giacomofratus/Stretcher_Stabilization/README.md

# Stretcher_Stabilization
Capstone project for UCLA EE183
