giacomofratus/Stretcher_Stabilization/Webot_Simulation/README.md

Files with "Uncompensated" in name have results for uncompensated system. Other files have results for compensated system

150kg.doc: Results for {misc,gust,step,sin} disturbance on 150kg body

1Off.doc:  Results for {misc} disturbance with 1 Device Off Center on Average body

2OffDiff.doc: Results for {misc} disturbance with 2 Device Off Center in Different Direction on Average body

2OffSame.doc: Results for {misc} disturbance with 2 Device Off Center in Same Direction on Average body

3SDAbove.doc: Results for {misc,gust,step,sin} disturbance on 3SD Above Average body

3SDBelow.doc: Results for {misc,gust,step,sin} disturbance on 3SD Below Average body

Empty Stretcher Max Gust.doc: Results for {maxgust} disturbance on Empty Stretcher

Empty Stretcher Max Step.doc: Results for {maxstep} disturbance on Empty Stretcher

Empty Stretcher.doc: Results for {misc,gust,step,sin} disturbance on Empty Stretcher

Head AvgBody Misc.doc:  Results for {misc} disturbance with Head Position on Average body

Statistical_Analysis.doc: Results Statistical Analysis for {misc,gust,step,sin} disturbance on Average body

Tail AvgBody Misc.doc: Results for {misc} disturbance with Tail Position on Average body

Uncompensated 150kg.doc: Results for {misc,gust,step,sin} disturbance on 150kg body

Uncompensated 1Off.doc: Results for {misc} disturbance with 1 Device Off Center on Average body

Uncompensated 2OffDiff.doc: Results for {misc} disturbance with 2 Device Off Center in Different Direction on Average body

Uncompensated 2OffSame.doc: Results for {misc} disturbance with 2 Device Off Center in Same Direction on Average body
 
Uncompensated 3SD Above.doc: Results for {misc,gust,step,sin} disturbance on 3SD Above Average body

Uncompensated 3SD Below.doc: Results for {misc,gust,step,sin} disturbance on 3SD Below Average body

Uncompensated 3SDAbove Head.doc: Results for {misc,gust,step,sin} disturbance with Head Position on 3SD Above Average body

Uncompensated Average Body.doc: Results for {misc,gust,step,sin} disturbance on Average body

Uncompensated Empty Stretcher.doc: Results for {misc,gust,step,sin} disturbance on Empty Stretcher

Uncompensated Head 150kg.doc: Results for {misc,gust,step,sin} disturbance with Head Position on 150kg body

Uncompensated Head 3SDBelow.doc: Results for {misc,gust,step,sin} disturbance with Head Position on 3SD Below Average body

Uncompensated Head AvgBody.doc: Results for {misc,gust,step,sin} disturbance with Head Position on Average body

Uncompensated Tail 150kg.doc: Results for {misc,gust,step,sin} disturbance with Tail Position on 150kg body

Uncompensated Tail 3SDAbove.doc: Results for {misc,gust,step,sin} disturbance with Tail Position on 3SD Above Average body

Uncompensated Tail 3SDBelow.doc: Results for {misc,gust,step,sin} disturbance with Tail Position on 3SD Below Average body

Uncompensated Tail AvgBody.doc: Results for {misc,gust,step,sin} disturbance with Tail Position on Average body

avgBody.doc: Results for {misc,gust,step,sin} disturbance on Average body
