giacomofratus/Stretcher_Stabilization/Technical_Drawings/README.txt

README

This folder contains all the drawings for the main and sub-assemblies. All drawings are for the main assembly, with a special folder for parts in the sub-assembly that excludes parts not in the main assembly.
