giacomofratus/Stretcher_Stabilization/Analytical Simulation/System Dynamics/README

Document(s) outlining the mathmatical models we use to simulate a rotating body, rotational inertia, actuator thrust, and disturbance
