giacomofratus/Stretcher_Stabilization/Technical_Drawings/chassis_part.JPG

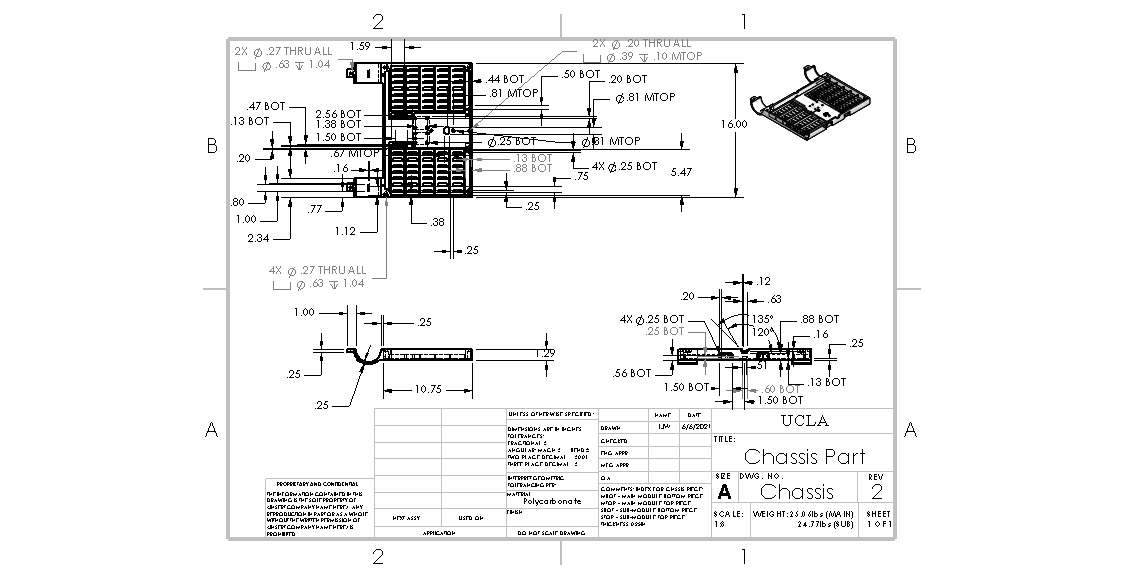
Technical_Drawings/chassis_part.JPG
