giacomofratus/Stretcher_Stabilization/Technical_Drawings/Corner Mount.JPG

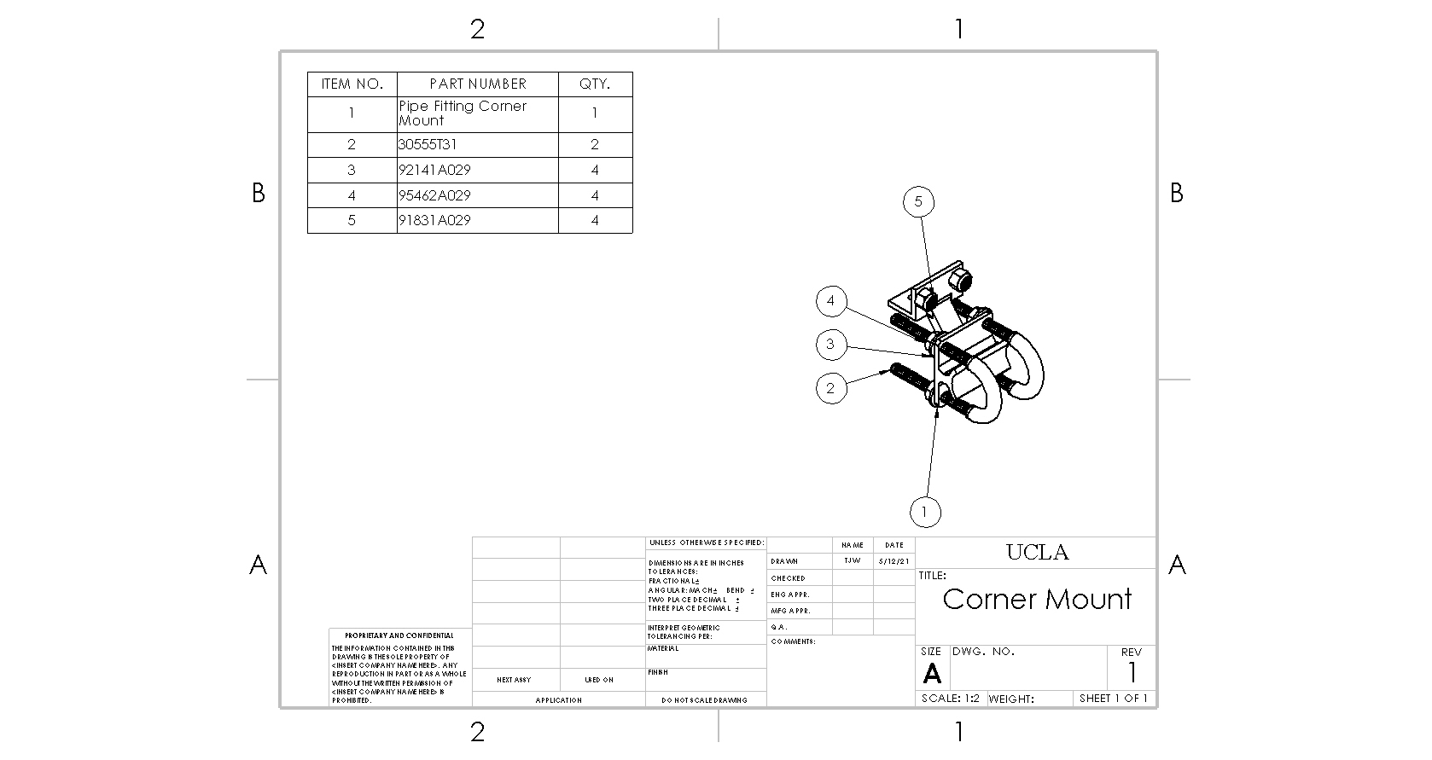
Technical_Drawings/Corner Mount.JPG
