giacomofratus/Stretcher_Stabilization/Technical_Drawings/CPU Housing-1.jpg

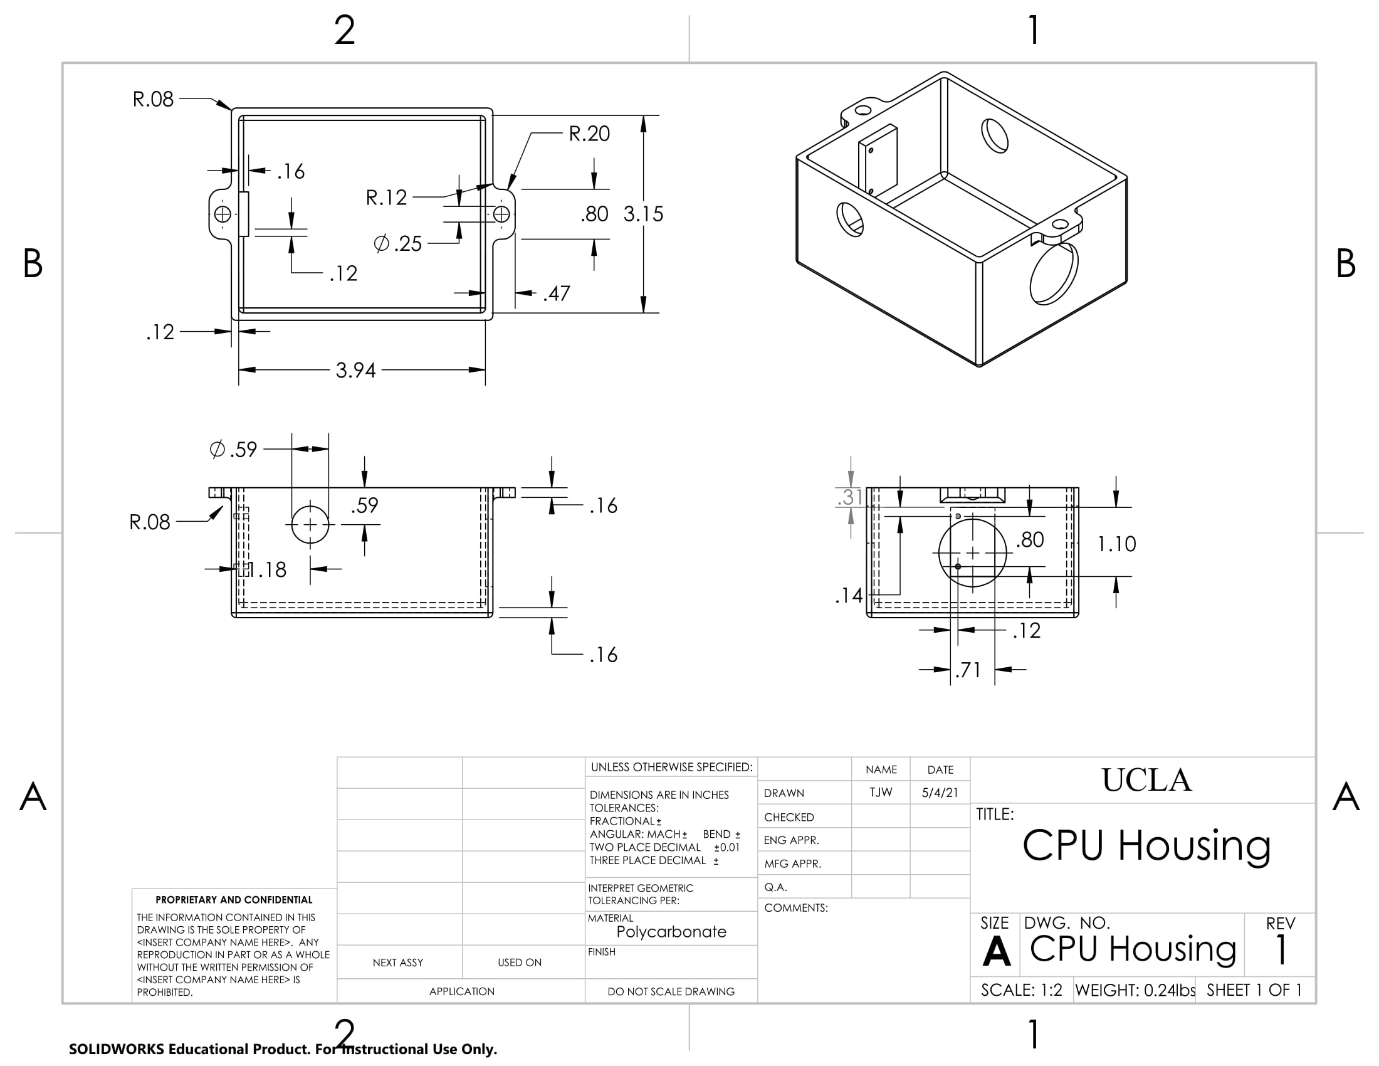
Technical_Drawings/CPU Housing-1.jpg
