giacomofratus/Stretcher_Stabilization/Technical_Drawings/ElectricHousingFULL.JPG

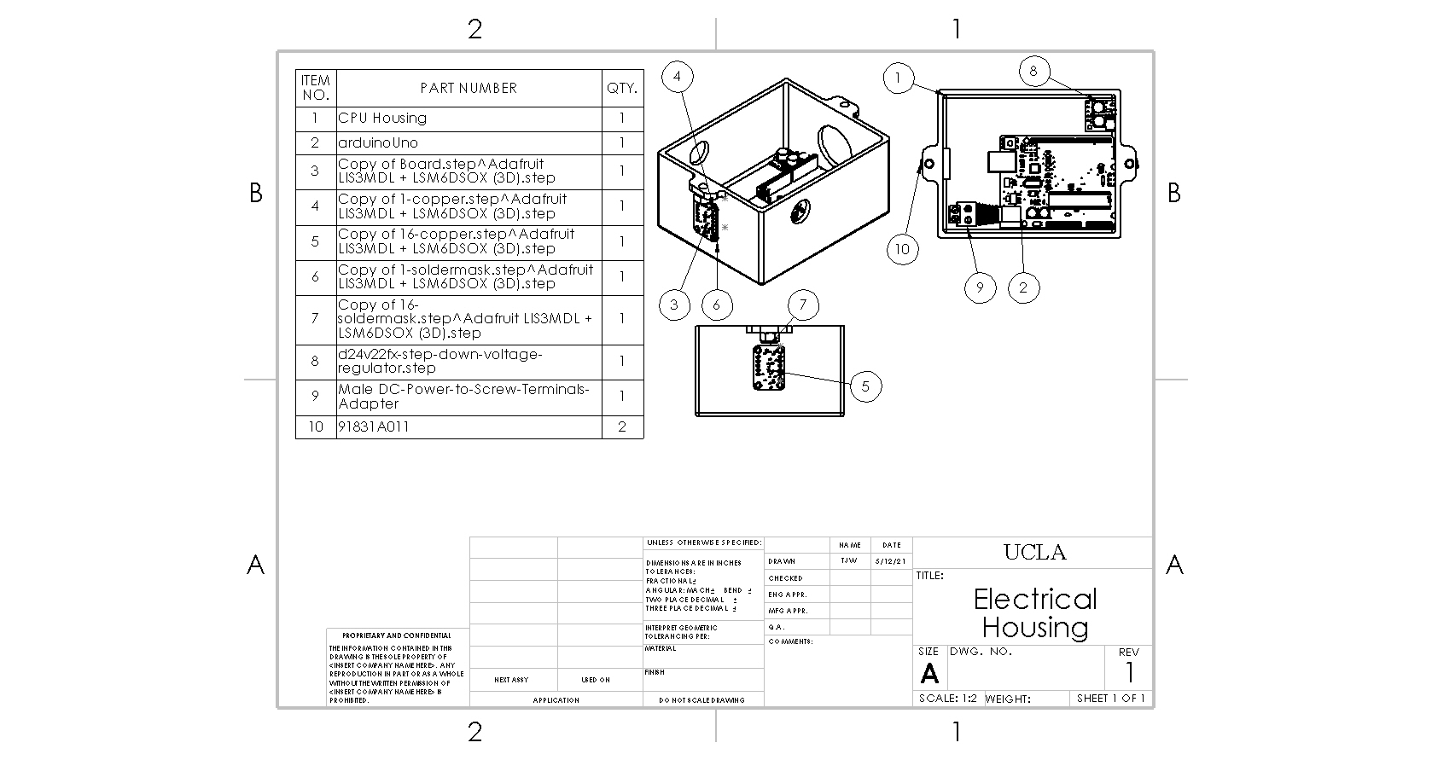
Technical_Drawings/ElectricHousingFULL.JPG
