giacomofratus/Stretcher_Stabilization/Technical_Drawings/foam_battery-1.jpg

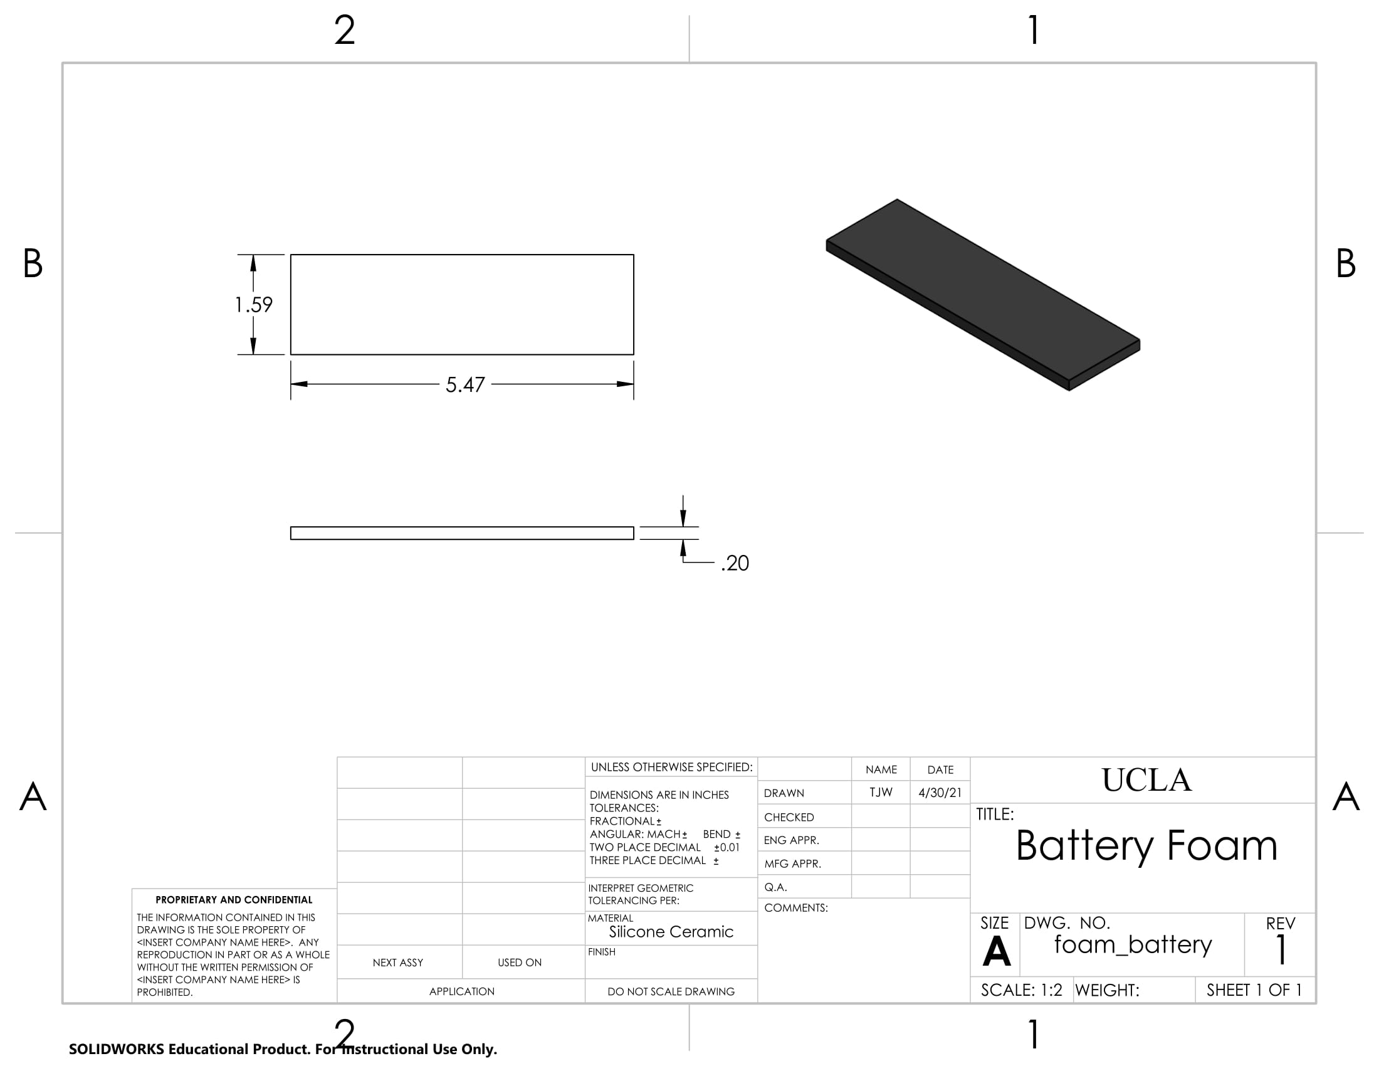
Technical_Drawings/foam_battery-1.jpg
