giacomofratus/Stretcher_Stabilization/Technical_Drawings/foam_ESC-1.jpg

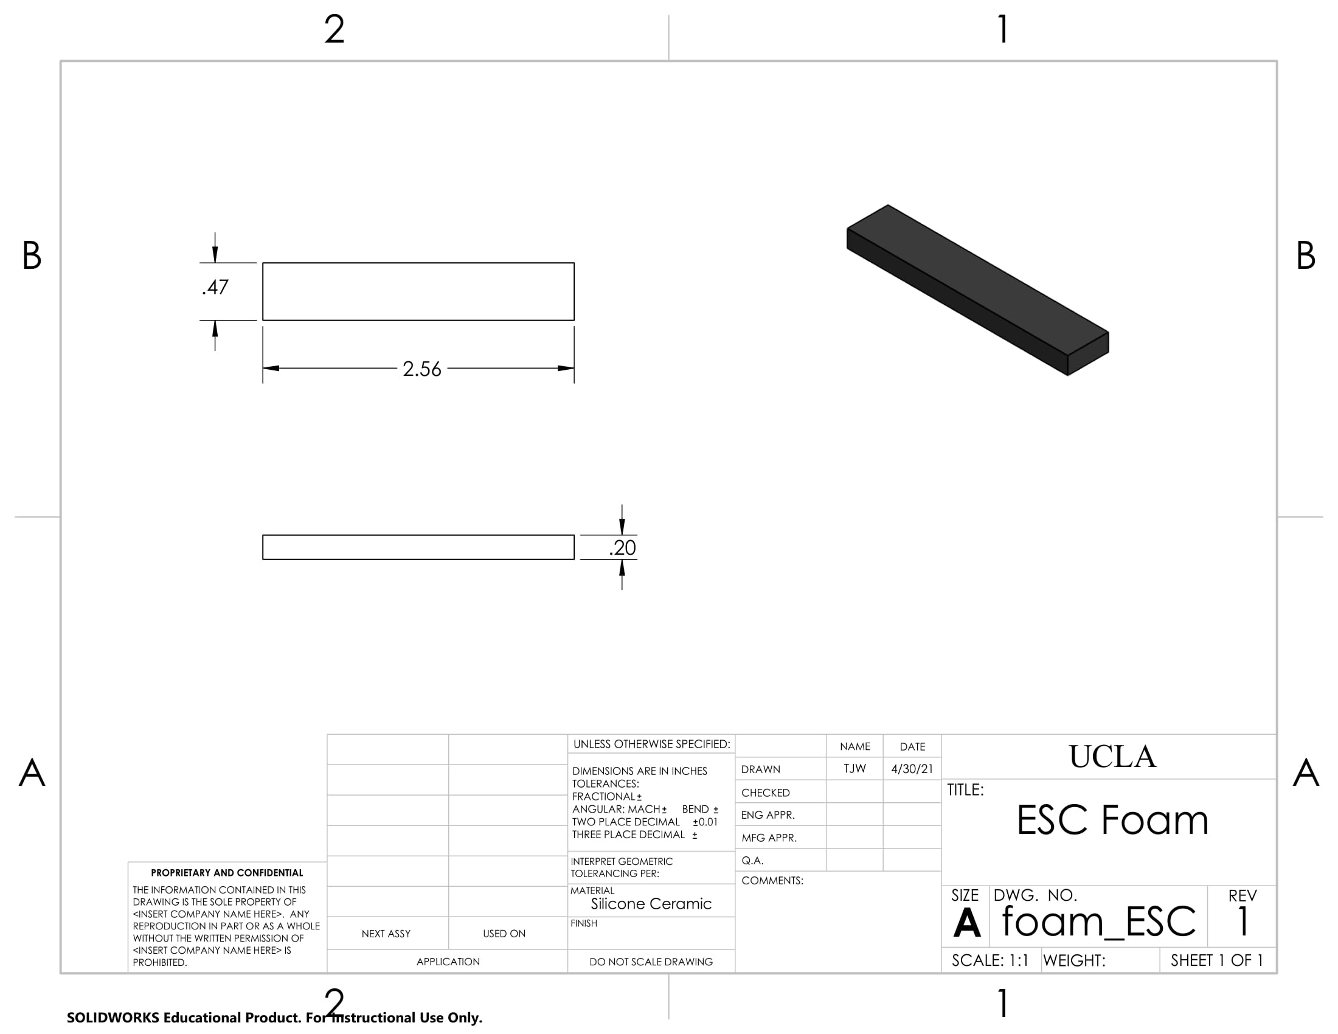
Technical_Drawings/foam_ESC-1.jpg
