giacomofratus/Stretcher_Stabilization/Technical_Drawings/LIS3MDL.png

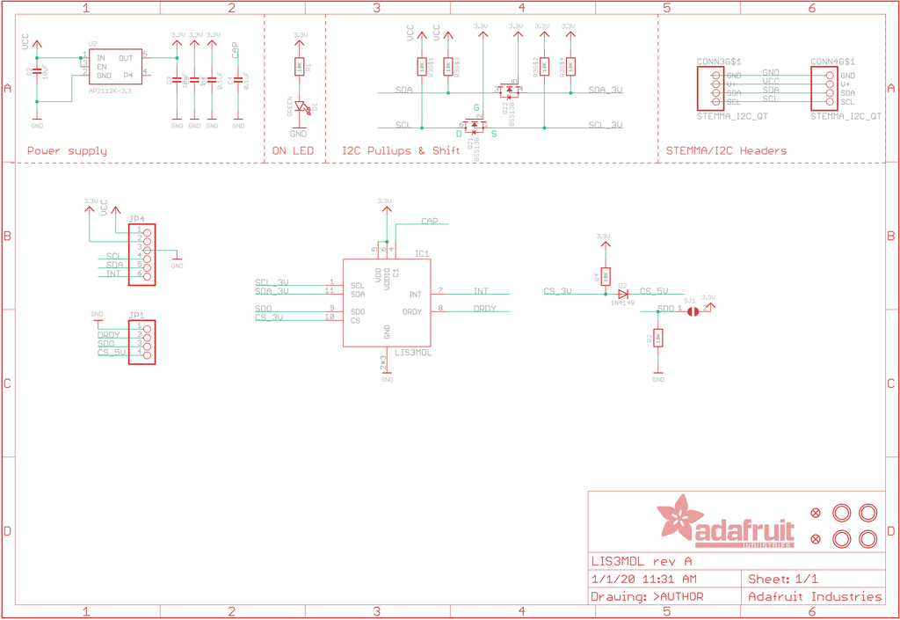
Technical_Drawings/LIS3MDL.png
