giacomofratus/Stretcher_Stabilization/Technical_Drawings/LSM6DSOX.png

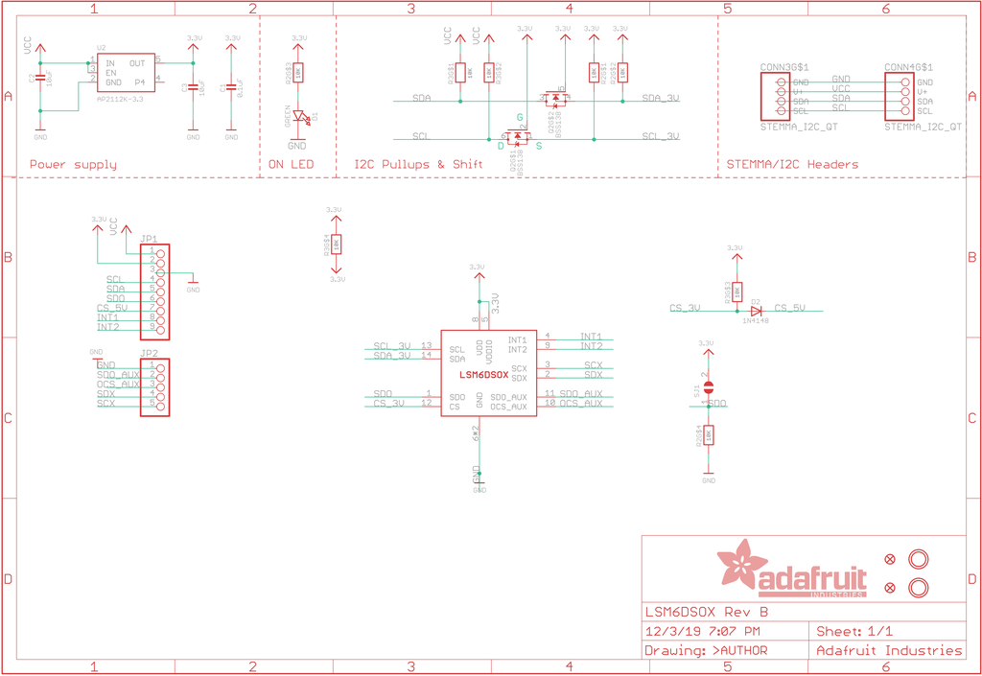
Technical_Drawings/LSM6DSOX.png
