giacomofratus/Stretcher_Stabilization/Technical_Drawings/pf-edf-70mm.png

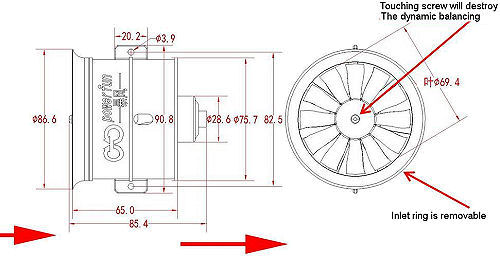
Technical_Drawings/pf-edf-70mm.png
