giacomofratus/Stretcher_Stabilization/Technical_Drawings/Pipe Fitting Corner Mount-1.jpg

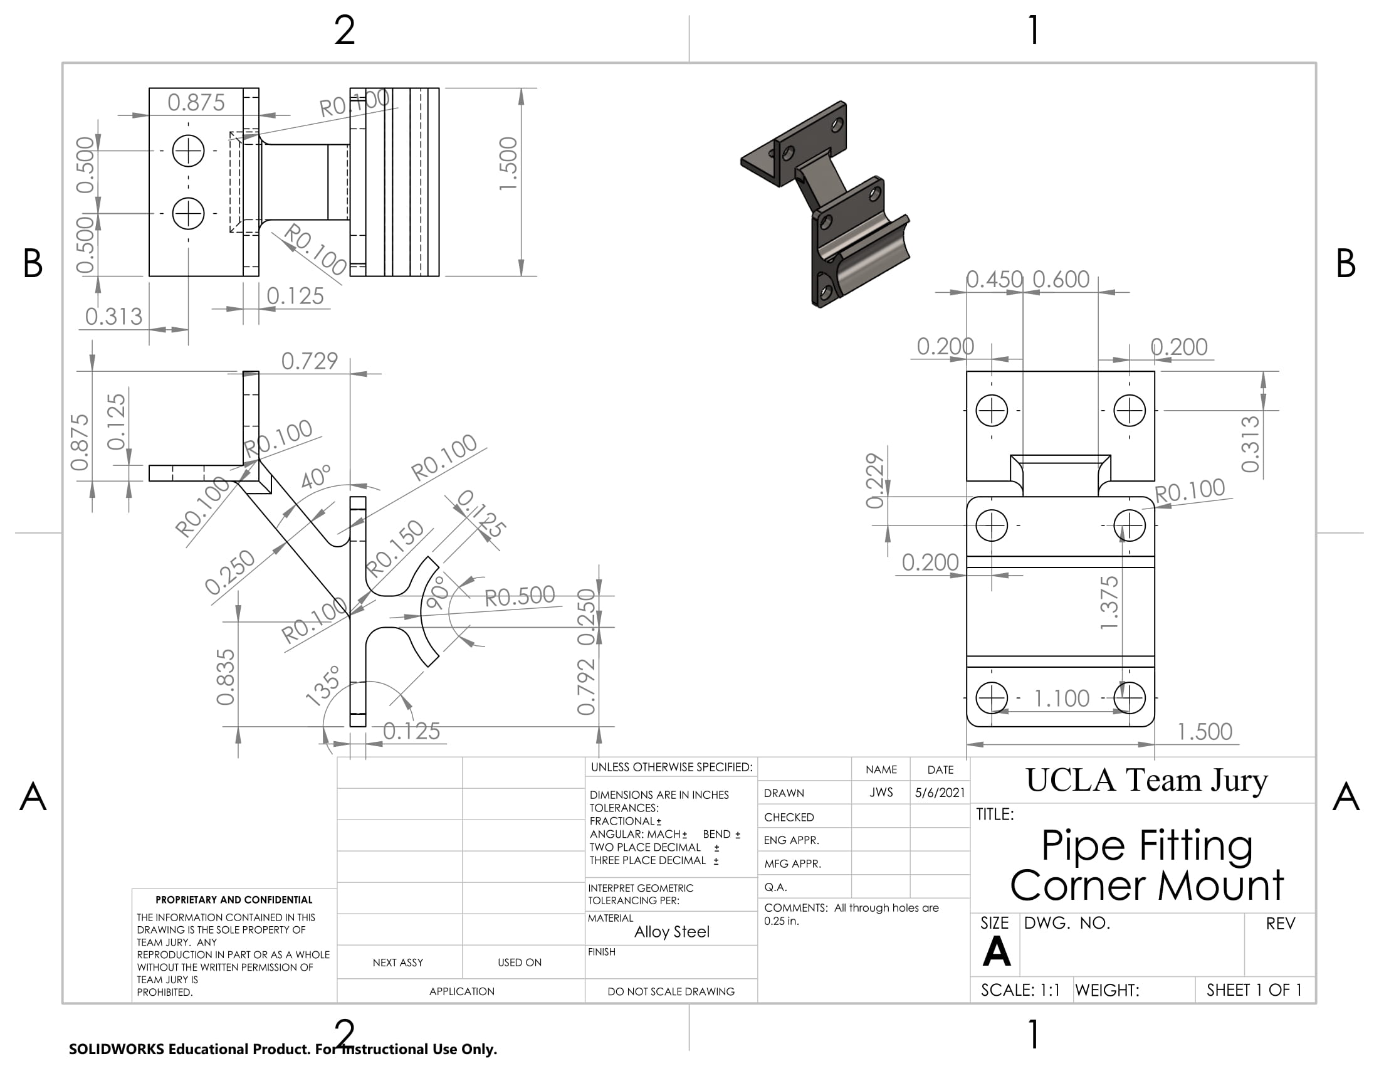
Technical_Drawings/Pipe Fitting Corner Mount-1.jpg
