giacomofratus/Stretcher_Stabilization/Technical_Drawings/Pipe Fitting Hole-1.jpg

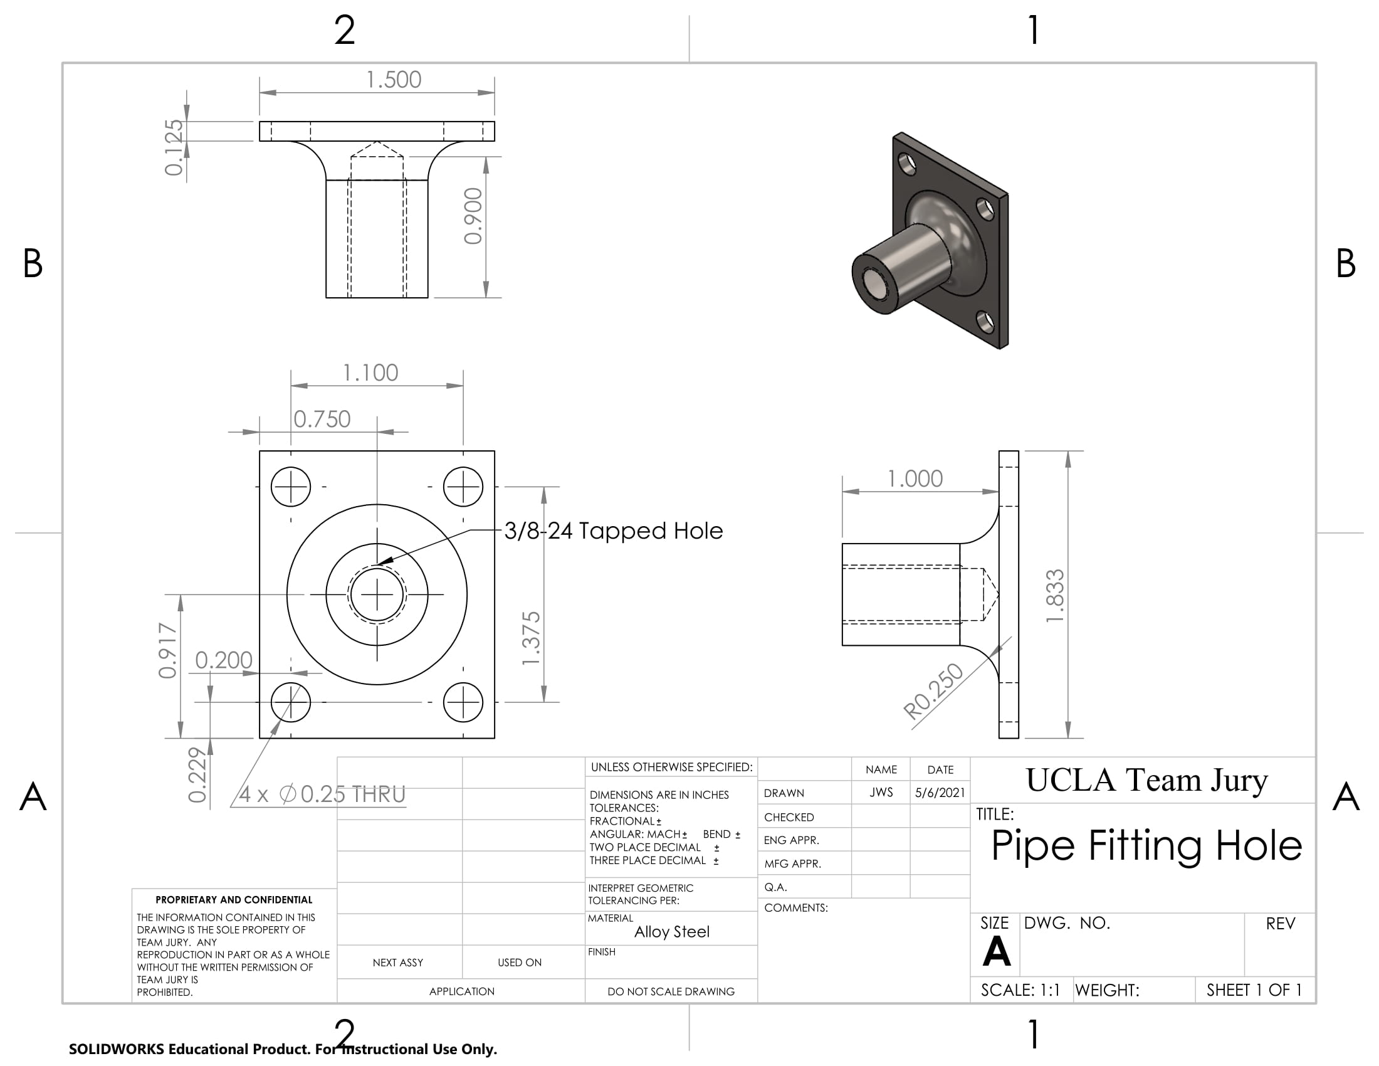
Technical_Drawings/Pipe Fitting Hole-1.jpg
