giacomofratus/Stretcher_Stabilization/Technical_Drawings/Pipe Fitting-1.jpg

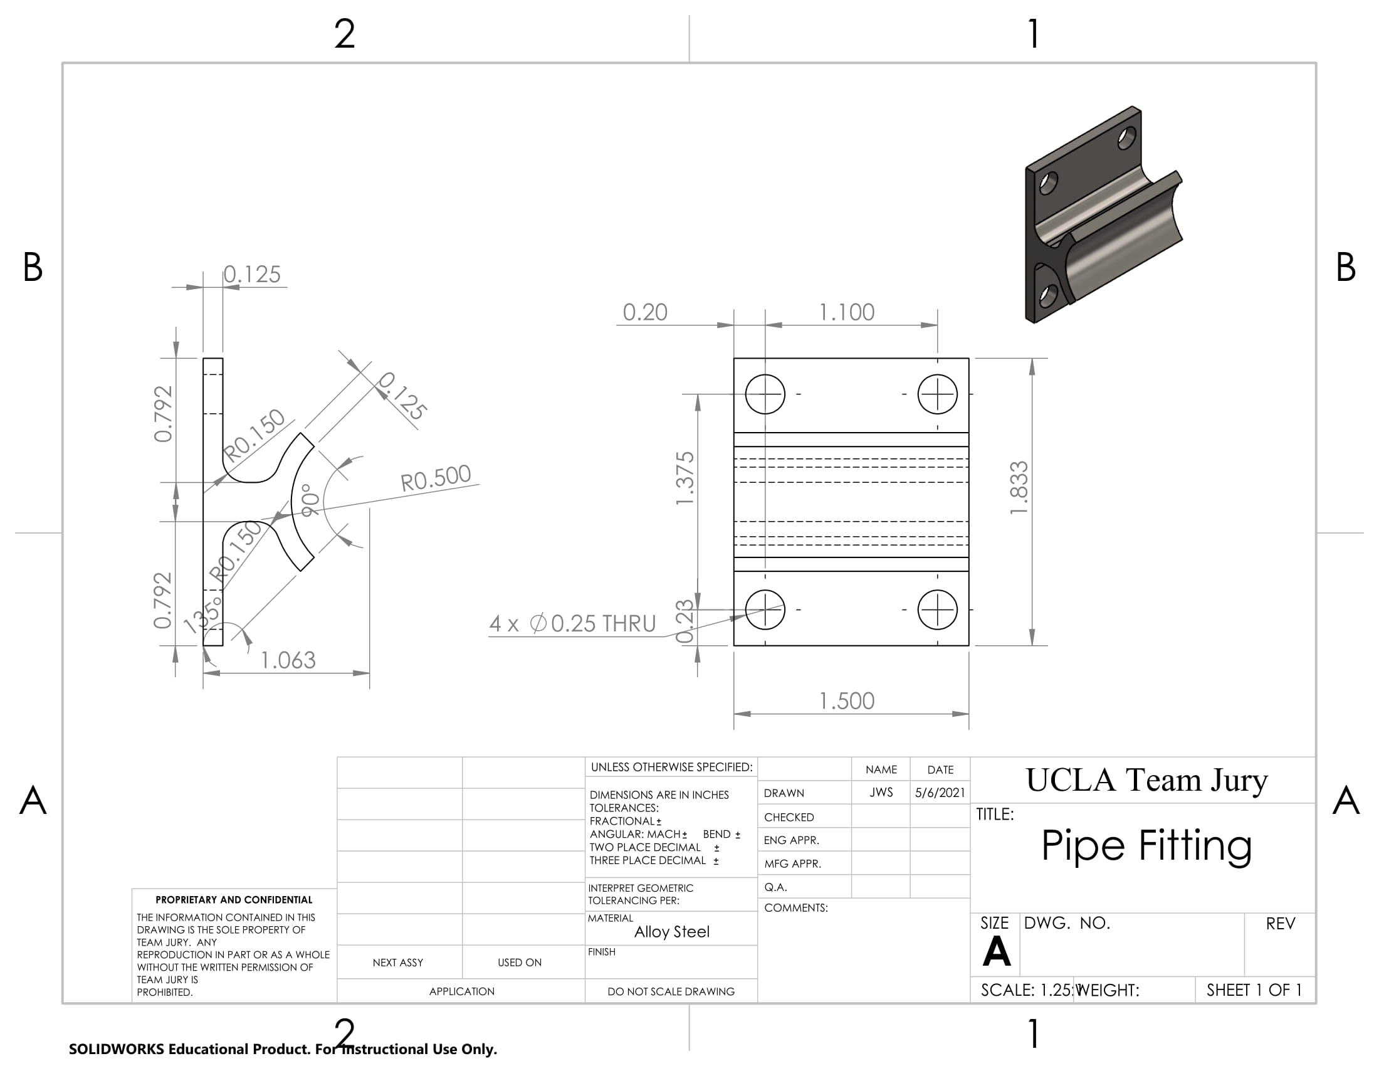
Technical_Drawings/Pipe Fitting-1.jpg
