giacomofratus/Stretcher_Stabilization/Technical_Drawings/Underside Chassis Mount Inline V2.JPG

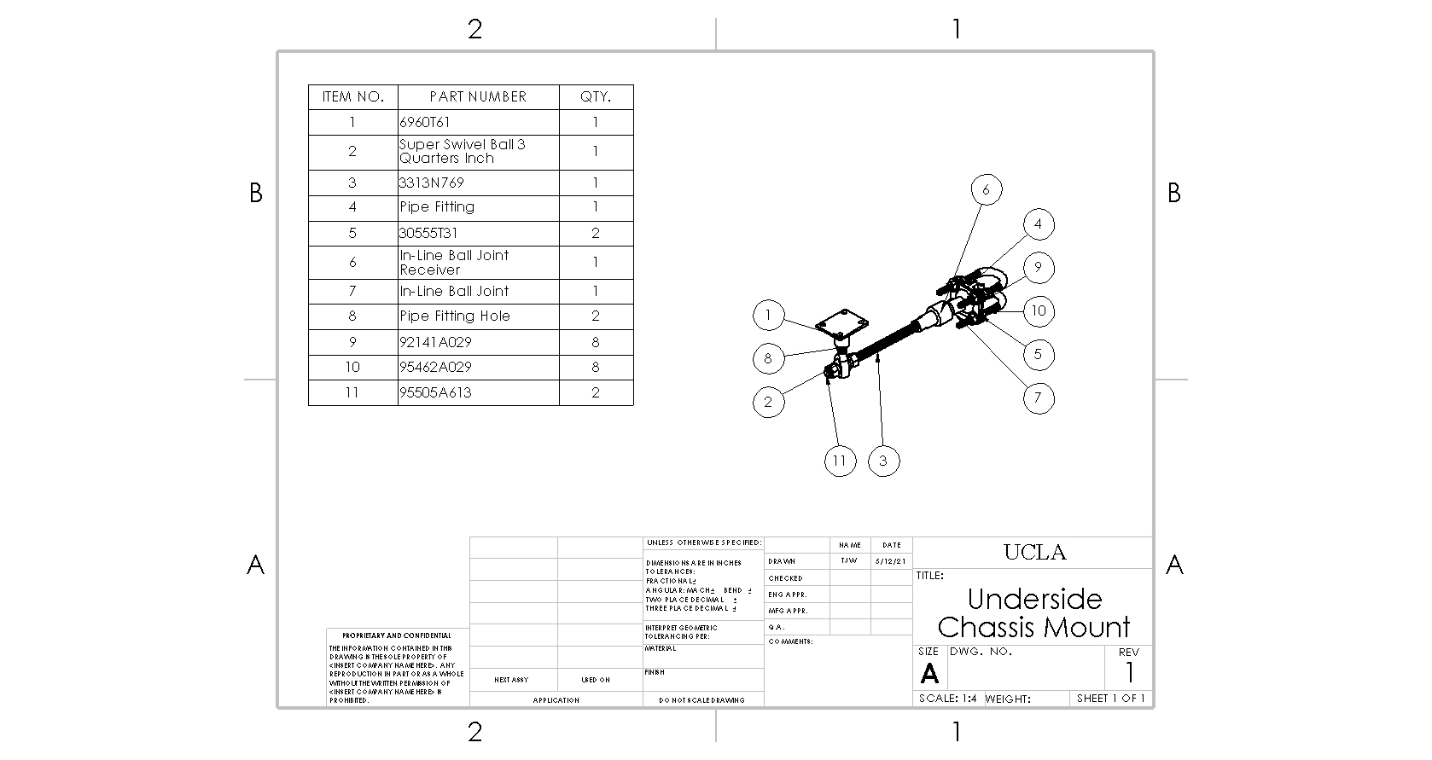
Technical_Drawings/Underside Chassis Mount Inline V2.JPG
