giacomofratus/Stretcher_Stabilization/3_PIN_Female_DIN_Solder_Connector.SLDPRT

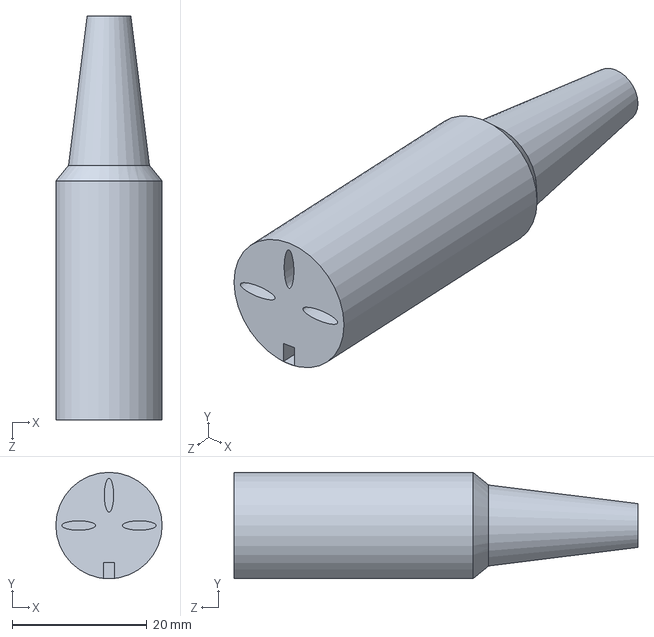
[picture p21: CAD file, 2021-06-11, last stored version]
3_PIN_Female_DIN_Solder_Connector.SLDPRT
15.8 x 15.8 x 60.0 mm
