giacomofratus/Stretcher_Stabilization/Technical_Drawings/chassis_assembly.JPG

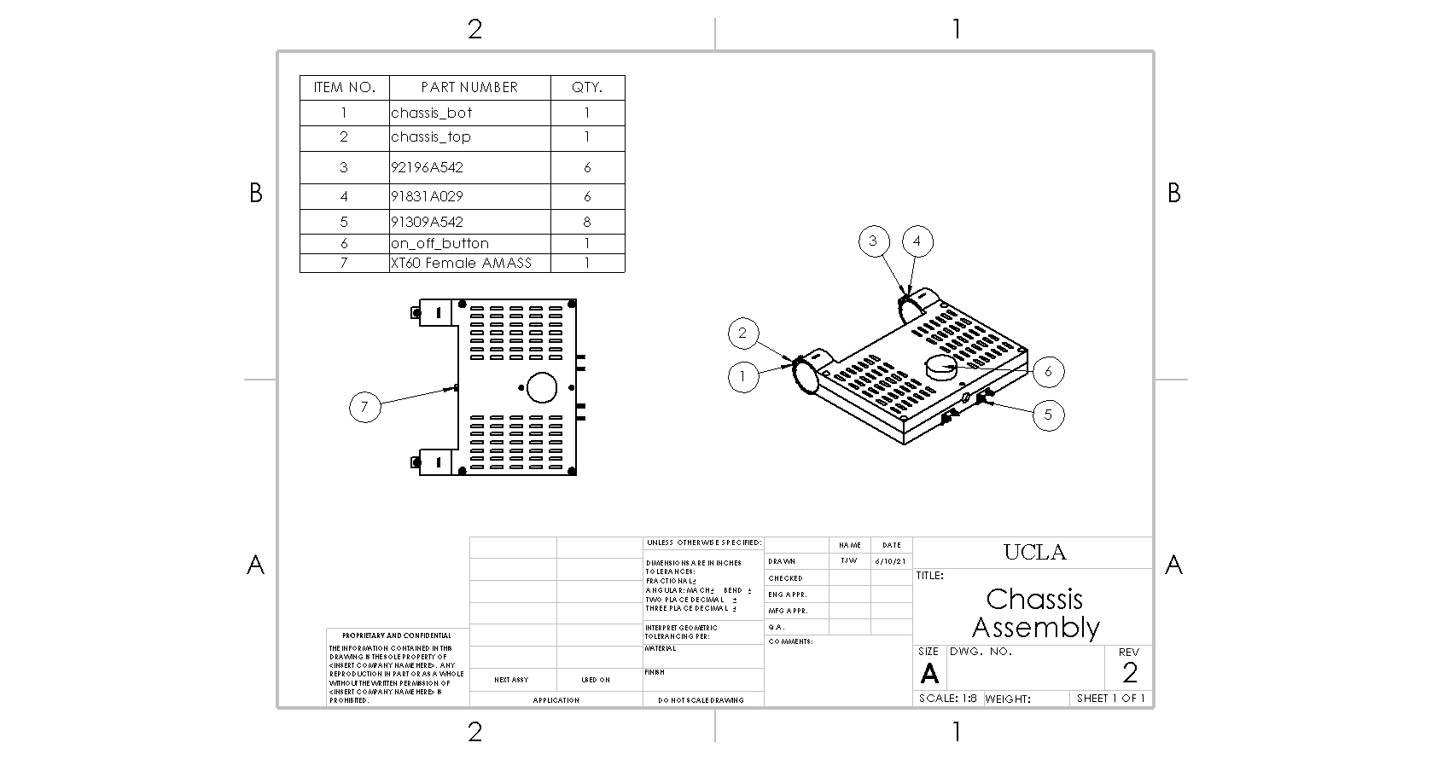
Technical_Drawings/chassis_assembly.JPG
