giacomofratus/Stretcher_Stabilization/Technical_Drawings/module_assembly.JPG

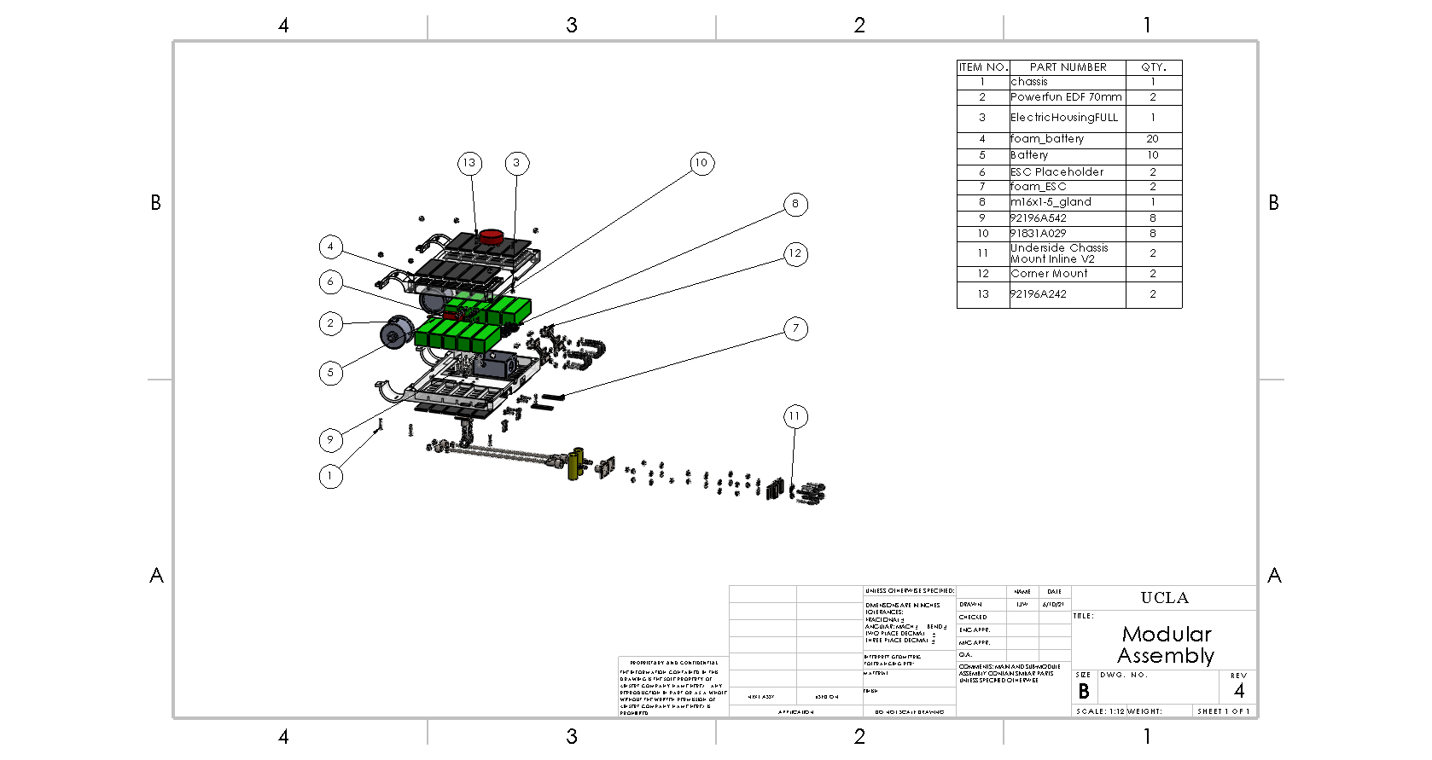
Technical_Drawings/module_assembly.JPG
