giacomofratus/Stretcher_Stabilization/Technical_Drawings/Pipe Fitting Assembly.JPG

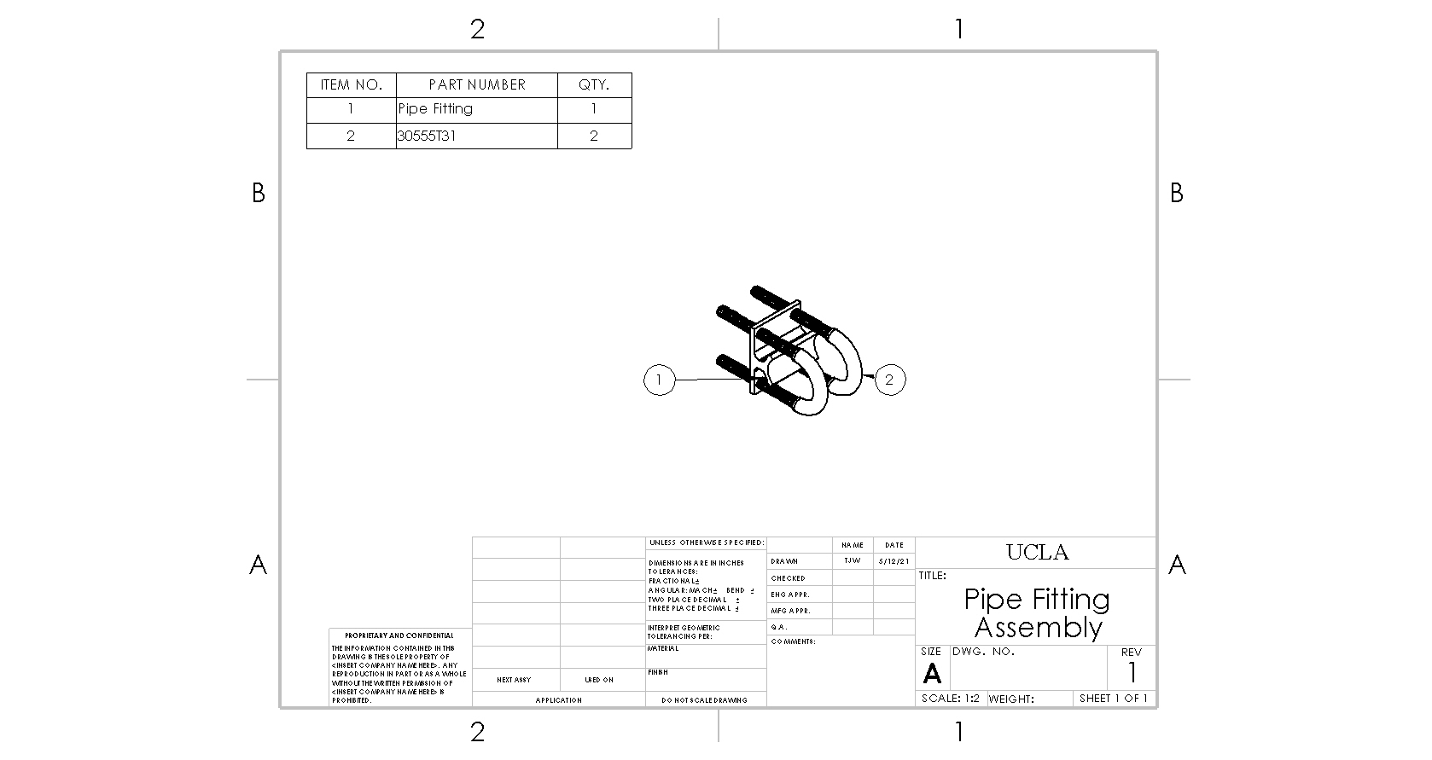
Technical_Drawings/Pipe Fitting Assembly.JPG
