giacomofratus/Stretcher_Stabilization/Analytical Simulation/Safety_Measure_Derivation.pdf

Safety Measures Derivation:

Here are the definitions that will be used in this section:

Parameter | Definition | Units
t | Time | Seconds
r | Distance of patient’s head to center of rotation | Meters
θ(t) | Angle of stretcher with respect to original position, function of time | Radians
dθ(t) ω(t) = dt | Angular Velocity of stretcher, function of time | Radians/Second
dω(t) α(t) = dt | Angular Acceleration of stretcher, function of time | Radians/(Seconds^2)
x(t) | Position vector of patient’s head with respect to standard (non – rotating) reference frame. | Meters
dx(t) v(t) = dt | Velocity vector of patient’s head with respect to standard (non-rotating) reference frame. | Meters/Second
dv(t) a(t) = dt | Acceleration vector of patient’s head with respect to standard (non-rotating) reference frame. | Meters/(Second^2)
da(t) J(t) = dt | Jerk vector of patient’s head with respect to standard (non-rotating) reference frame. | Meters/(Second^3)
uR(t) | Radial Direction vector in current alignment with stretcher | N/A
uT(t) | Tangential direction vector in alignment with current tangential direction of the stretcher | N/A
vT (t) =< uT (t), v(t) > | Tangential linear velocity of the patient’s head | Meters/Second
aT (t) =< uT (t), a(t) > | Tangential linear acceleration of the patient’s head | Meters/(Second^2)
aR(t) =< uR(t), a(t) > | Radial linear acceleration of the patient’s head | Meters/(Second^2)

The position of the patient’s head in the stretcher can be modeled by the following vector x(t)

x(t) = r ∗ (

cos(θ(t))
sin(θ(t))

)

Taking the derivative of x(t) with respect to time, we obtain v(t), linear velocity vector

v(t) = r ∗ (

−ω(t)sin(θ(t))
ω(t)cos(θ(t))

)

Taking the derivative of v(t) with respect to time, we obtain a(t), acceleration velocity vector

a(t) = r ∗ (

−α(t) sin(θ(t)) − ω(t)

2
cos (θ(t))
α(t) cos(θ(t)) − ω(t)

2 sin(θ(t))

)

Taking the derivative of a(t) with respect to time, we obtain J(t), the jerk vector

J(t) = r ∗ (

−α

′
(t) sin(θ(t)) − α(t)ω(t) cos(θ(t)) + ω(t)

3
sin(θ(t)) − 2α(t)ω(t)cos(θ(t)) α

′(t) cos(θ(t)) − α(t)ω(t) sin(θ(t)) − ω(t)

3 cos(θ(t)) − 2α(t)ω(t)sin (θ(t))

)

= r ∗ (

(ω(t)

3 − α

′
(t)) sin(θ(t)) + (−3α(t)ω(t)) cos(θ(t)) −(ω(t)
3 − α

′(t)) cos(θ(t)) + (−3α(t)ω(t)) sin(θ(t))

)

Define the unit radial and tangential vector as the following

uR(t) = (

cos(θ(t))
sin(θ(t))

) , uT

(t) = (
−sin (θ(t))
cos (θ(t))

)

Using these vectors to evaluate tangential velocity:

vT

(t) =< uT

(t), v(t) > = r ∗ ω(t)

Using these vectors to evaluate absolute tangential acceleration:

|aT

(t)| = |< uT

(t), a(t) >| = r ∗ |α(t)|

Using these vectors to evaluate absolute radial acceleration:

|aR(t)| = |< uR(t), a(t) >| = r ∗ ω(t)

2

Taking the magnitude of the Jerk vector:

|J(t)| = √(ω(t)

3 −

dα(t)
dt

)

2
+ (3α(t)ω(t))

2

From research, humans can take maximum acceleration of 5gs in direction of spine and 10gs in direction perpendicular to spine. People in the stretcher might be injured, so divide each acceleration value by 10 to obtain bounds with safety measures:

Note: 1g = 9.81 (

m
s

2

) ,take r = 1.1 m

|aR(t)| ≤ 0.5g

1.1 ∗ ω(t)

2 ≤ 0.5 ∗ (9.81)

|ω(t)| ≤ (2.11) (

rad
s

)

|aT

(t)| ≤ 1g

1.1 ∗ |α(t)| ≤ 1 ∗ (9.81)

|α(t)| ≤ 8.91 (

rad
s

2

)
