giacomofratus/Stretcher_Stabilization/Technical_Drawings/chassis_assembly.pdf

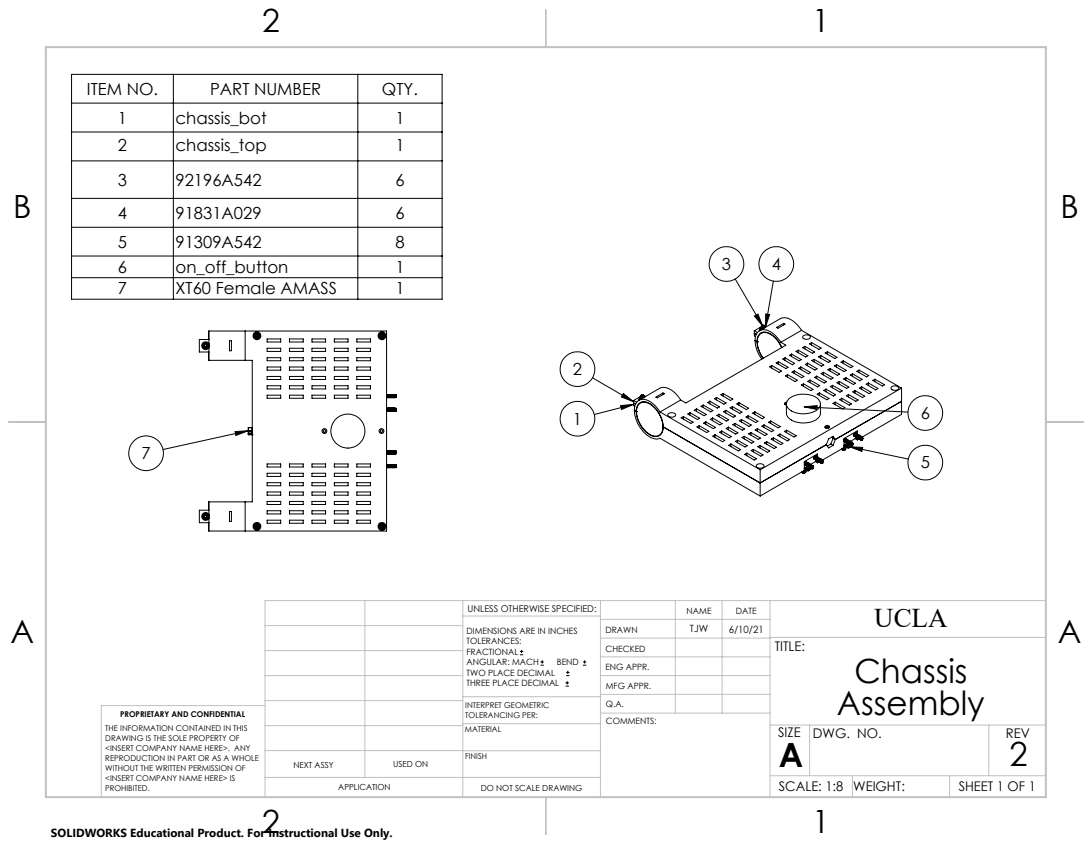
[picture p25: page 1]

ITEM NO. | PART NUMBER | QTY.
1 | chassis_bot | 1
2 | chassis_top | 1
3 | 92196A542 | 6
4 | 91831A029 | 6
5 | 91309A542 | 8
6 | on_off_button | 1
7 | XT60 Female AMASS | 1

UNLESS OTHERWISE SPECIFIED: | | | DATE | UCLA NAME
DIMENSIONS ARE IN INCHES TOLERANCES: FRACTIONAL ANGULAR: MACH BEND TWO PLACE DECIMAL THREE PLACE DECIMAL | DRAWN | TJW | 6/10/21

CHECKED | | | TITLE: Chassis Assembly

ENG APPR.
MFG APPR.

INTERPRET GEOMETRIC TOLERANCING PER: | Q.A.
MATERIAL | | SIZE A | DWG. NO. | REV 2

PROPRIETARY AND CONFIDENTIAL
THE INFORMATION CONTAINED IN THIS
DRAWING IS THE SOLE PROPERTY OF
<INSERT COMPANY NAME HERE>. ANY
REPRODUCTION IN PART OR AS A WHOLE
WITHOUT THE WRITTEN PERMISSION OF
<INSERT COMPANY NAME HERE> IS
PROHIBITED.

NEXT ASSY | USED ON | FINISH

APPLICATION | DO NOT SCALE DRAWING | | SCALE: 1:8 | WEIGHT: | SHEET 1 OF 1

SOLIDWORKS Educational Product. For Instructional Use Only.
