giacomofratus/Stretcher_Stabilization/Technical_Drawings/chassis_part.pdf

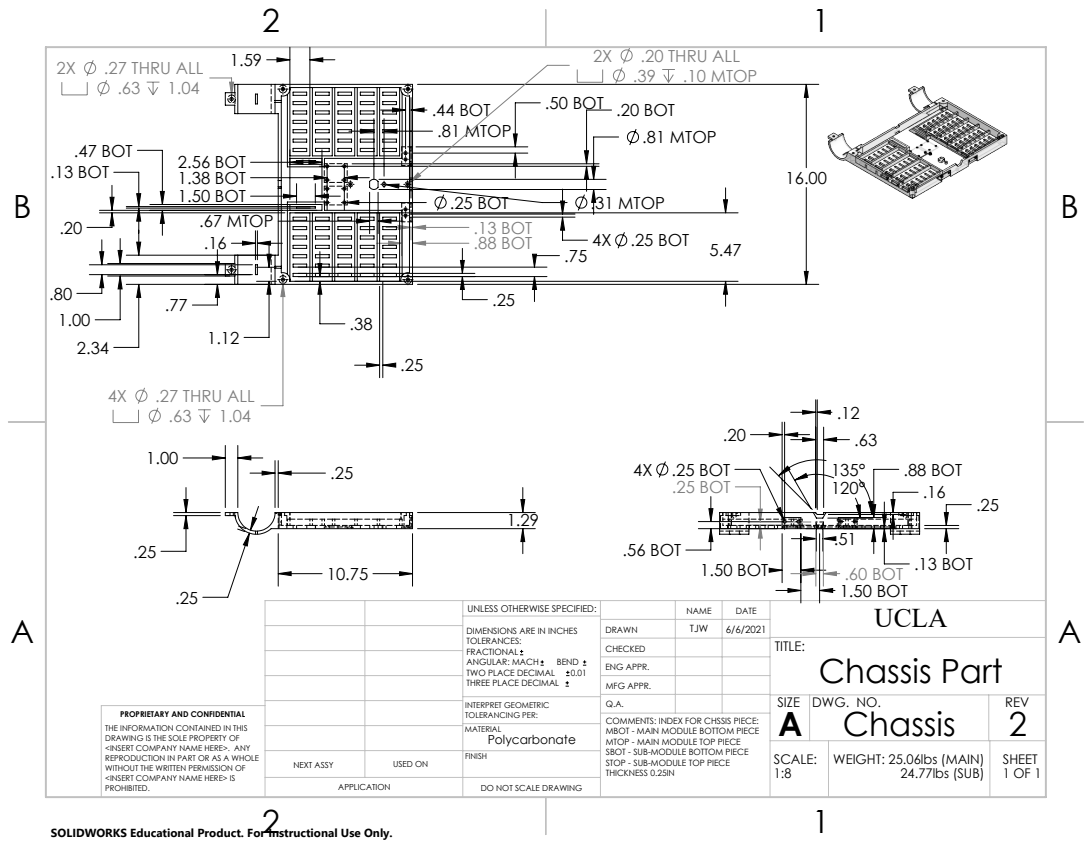
[picture p26: page 1]
1.50 BOT; .88 BOT; 4X .25 BOT; .56 BOT; .13 BOT; .25 BOT; .60 BOT; .27 THRU ALL; .47 BOT; 2.56 BOT; .44 BOT; .50 BOT; 1.38 BOT; .20 BOT; .31 MTOP; .20 THRU ALL; .39 .10 MTOP; .81 MTOP; .67 MTOP

UNLESS OTHERWISE SPECIFIED: | | | DATE | UCLA NAME
DIMENSIONS ARE IN INCHES TOLERANCES: FRACTIONAL ANGULAR: MACH BEND TWO PLACE DECIMAL 0.01 THREE PLACE DECIMAL | DRAWN | TJW | 6/6/2021
INTERPRET GEOMETRIC TOLERANCING PER: | Q.A. | | | SIZE A | DWG. NO. Chassis | REV 2

CHECKED | | | TITLE: Chassis Part

ENG APPR.
MFG APPR.

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

COMMENTS: INDEX FOR CHSSIS PIECE:
MBOT - MAIN MODULE BOTTOM PIECE
MTOP - MAIN MODULE TOP PIECE
SBOT - SUB-MODULE BOTTOM PIECE
STOP - SUB-MODULE TOP PIECE
THICKNESS 0.25IN

NEXT ASSY | USED ON | FINISH

SCALE: 1:8 | WEIGHT: 25.06lbs (MAIN) 24.77lbs (SUB) | SHEET 1 OF 1

APPLICATION | | DO NOT SCALE DRAWING

SOLIDWORKS Educational Product. For Instructional Use Only.
