giacomofratus/Stretcher_Stabilization/Technical_Drawings/module_assembly.pdf

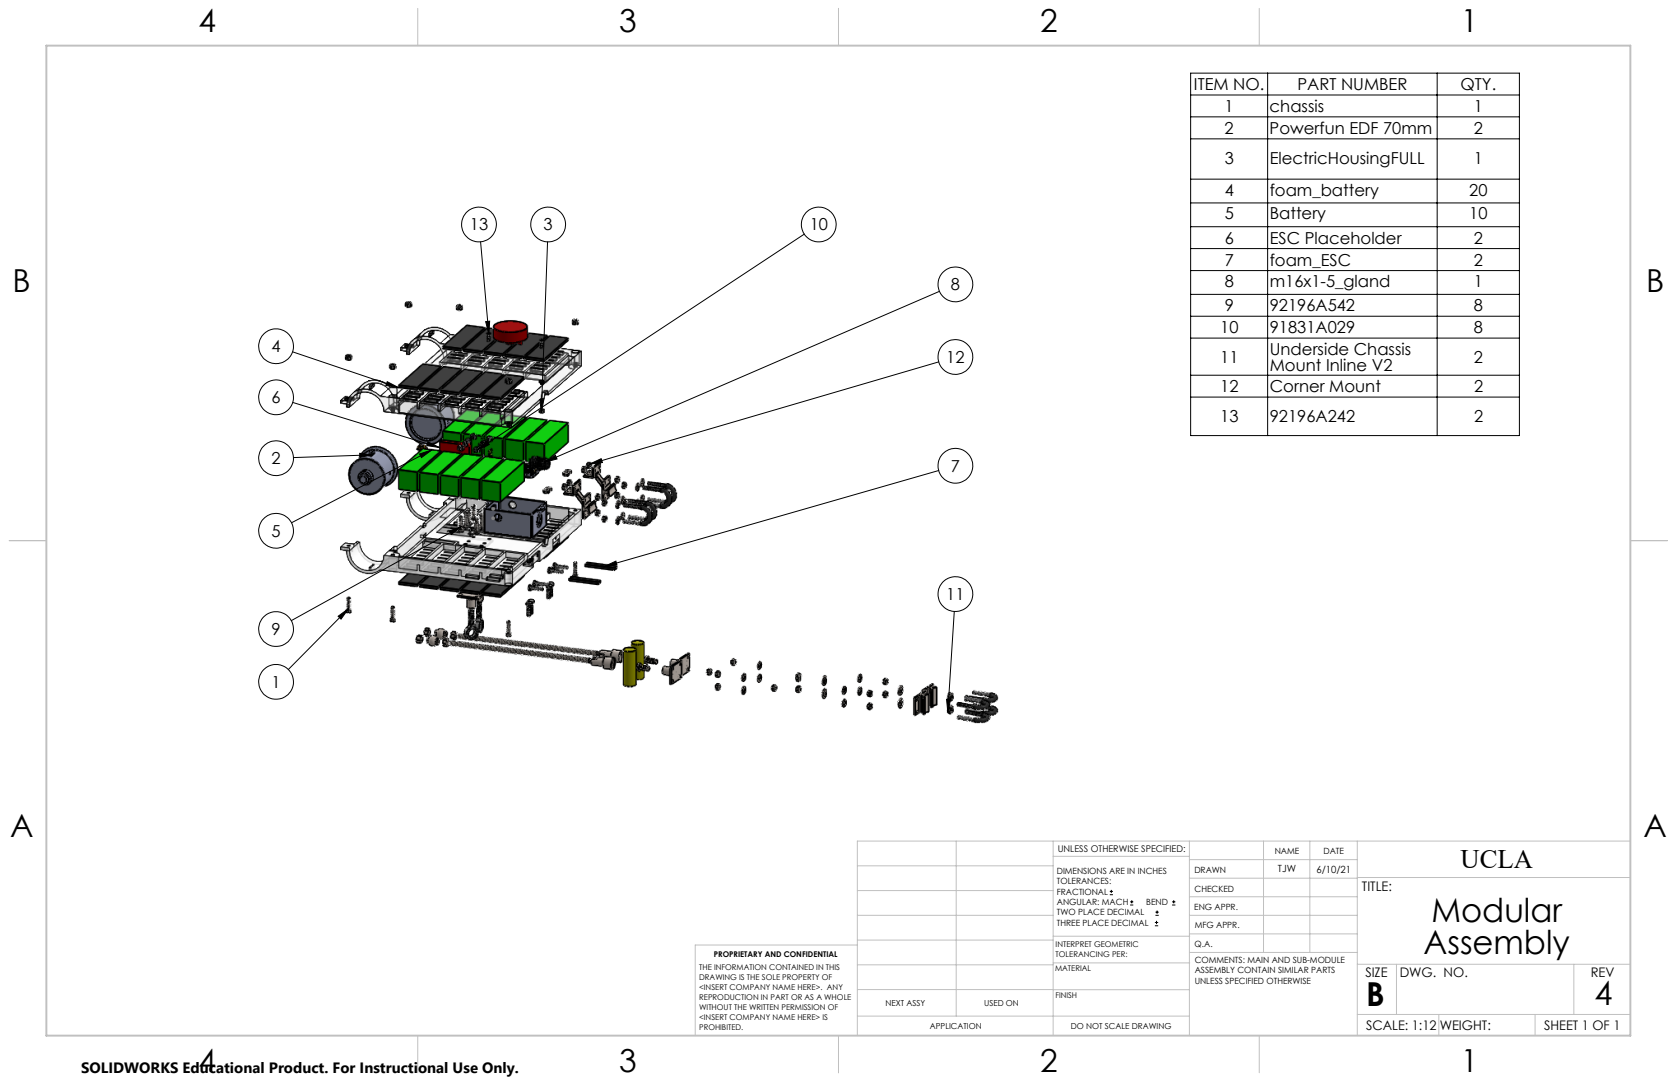
[picture p27: page 1]

ITEM NO. | PART NUMBER | QTY.
1 | chassis | 1
2 | Powerfun EDF 70mm | 2
3 | ElectricHousingFULL | 1
4 | foam_battery | 20
5 | Battery | 10
6 | ESC Placeholder | 2
7 | foam_ESC | 2
8 | m16x1-5_gland | 1
9 | 92196A542 | 8
10 | 91831A029 | 8
11 | Underside Chassis Mount Inline V2 | 2
12 | Corner Mount | 2
13 | 92196A242 | 2

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

CHECKED | | | TITLE: Modular Assembly

ENG APPR.
MFG APPR.

INTERPRET GEOMETRIC TOLERANCING PER: | Q.A.
MATERIAL | | SIZE B | DWG. NO. | REV 4

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

COMMENTS: MAIN AND SUB-MODULE
ASSEMBLY CONTAIN SIMILAR PARTS
UNLESS SPECIFIED OTHERWISE

NEXT ASSY | USED ON | FINISH

APPLICATION | DO NOT SCALE DRAWING | | SCALE: 1:12 WEIGHT: | | SHEET 1 OF 1

SOLIDWORKS Educational Product. For Instructional Use Only.
