giacomofratus/Stretcher_Stabilization/Technical_Drawings/Pipe Fitting Assembly.pdf

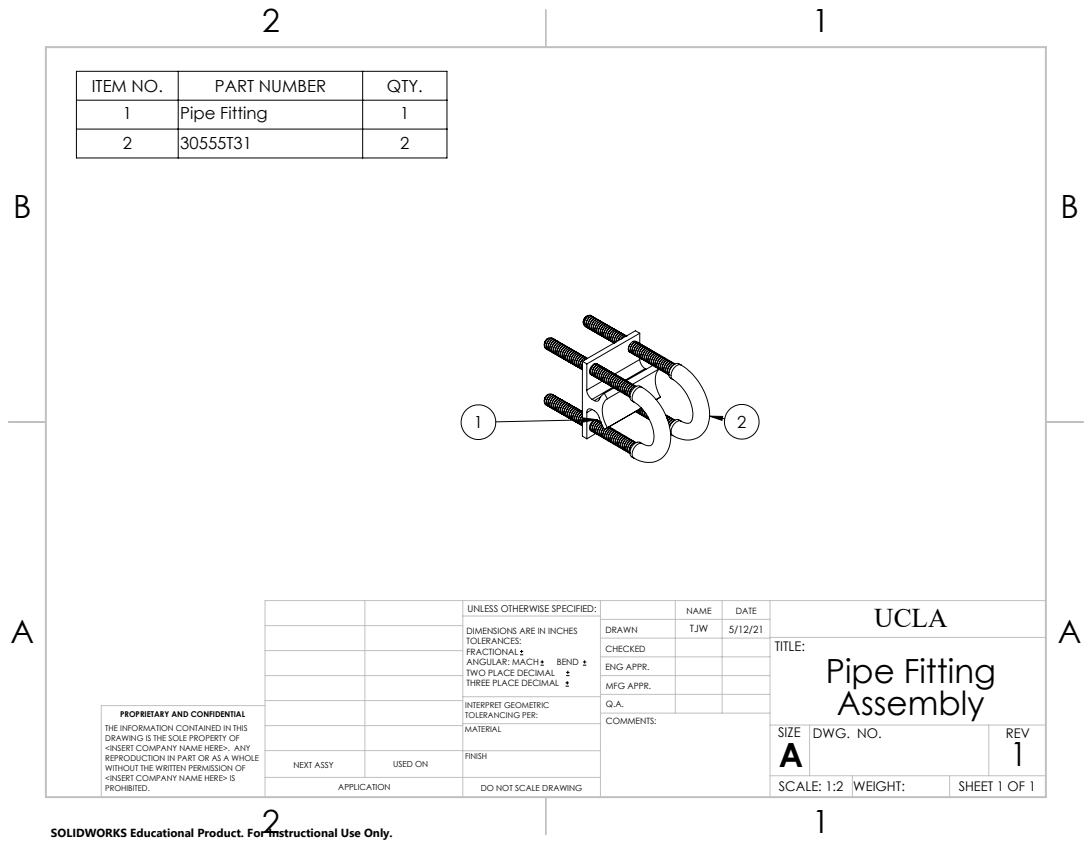
[picture p28: page 1]

ITEM NO. | PART NUMBER | QTY.
1 | Pipe Fitting | 1
2 | 30555T31 | 2

UNLESS OTHERWISE SPECIFIED: | | | DATE | UCLA NAME
DIMENSIONS ARE IN INCHES TOLERANCES: FRACTIONAL ANGULAR: MACH BEND TWO PLACE DECIMAL THREE PLACE DECIMAL | DRAWN | TJW | 5/12/21

CHECKED | | | TITLE: Pipe Fitting Assembly

ENG APPR.
MFG APPR.

INTERPRET GEOMETRIC TOLERANCING PER: | Q.A.
MATERIAL | | SIZE A | DWG. NO. | REV 1

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

NEXT ASSY | USED ON | FINISH

APPLICATION | DO NOT SCALE DRAWING | | SCALE: 1:2 | WEIGHT: | SHEET 1 OF 1

SOLIDWORKS Educational Product. For Instructional Use Only.
