giacomofratus/Stretcher_Stabilization/Technical_Drawings/Underside Chassis Mount Inline V2.pdf

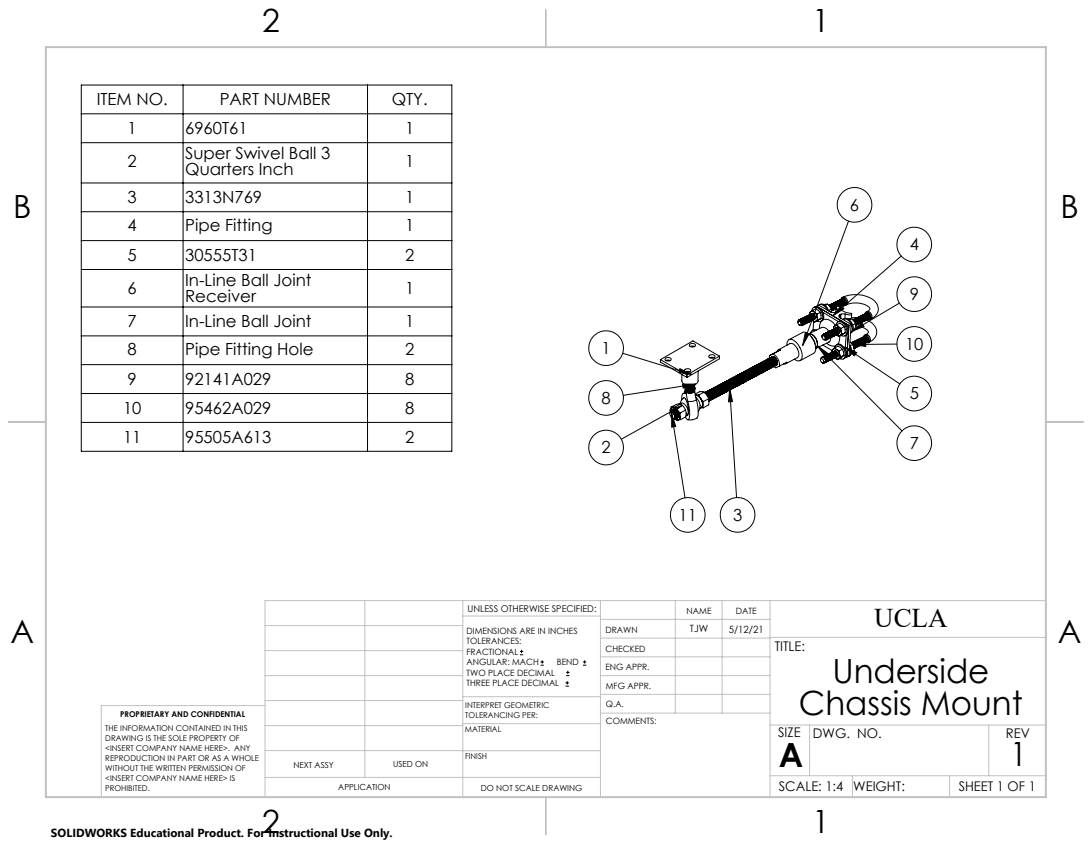
[picture p29: page 1]

ITEM NO. | PART NUMBER | QTY.
1 | 6960T61 | 1
2 | Super Swivel Ball 3 Quarters Inch | 1

3 | 3313N769 | 1
4 | Pipe Fitting | 1
5 | 30555T31 | 2
6 | In-Line Ball Joint Receiver | 1
7 | In-Line Ball Joint | 1
8 | Pipe Fitting Hole | 2
9 | 92141A029 | 8
10 | 95462A029 | 8
11 | 95505A613 | 2

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

CHECKED | | | TITLE: Underside Chassis Mount

ENG APPR.
MFG APPR.

INTERPRET GEOMETRIC TOLERANCING PER: | Q.A.
MATERIAL | | SIZE A | DWG. NO. | REV 1

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

NEXT ASSY | USED ON | FINISH

APPLICATION | DO NOT SCALE DRAWING | | SCALE: 1:4 | WEIGHT: | SHEET 1 OF 1

SOLIDWORKS Educational Product. For Instructional Use Only.
