giacomofratus/Stretcher_Stabilization/Technical_Drawings/30555T31_RUBBER-CUSHIONED U-BOLT.PDF

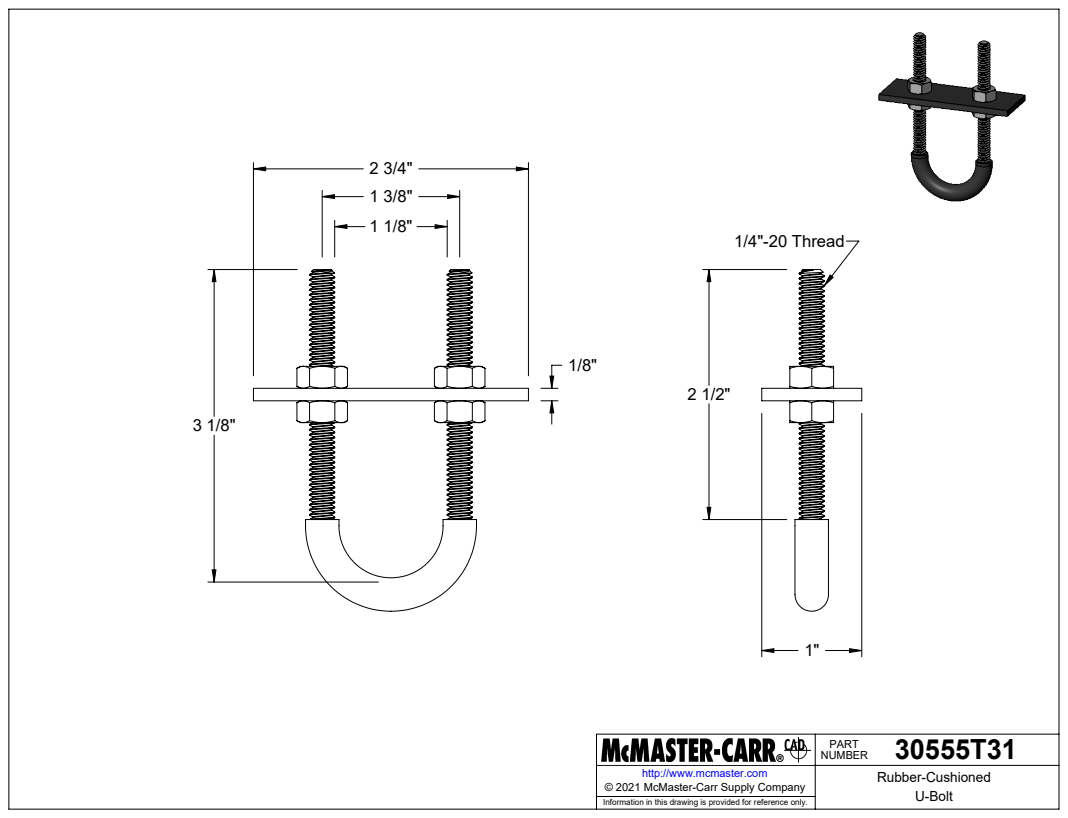
[picture p30: page 1]
1/4"-20 Thread

30555T31 PART NUMBER

http://www.mcmaster.com | Rubber-Cushioned U-Bolt © 2021 McMaster-Carr Supply Company

Information in this drawing is provided for reference only.
