giacomofratus/Stretcher_Stabilization/Technical_Drawings/3313N769_ HIGH STRENGTH STEEL THREADED ROD.PDF

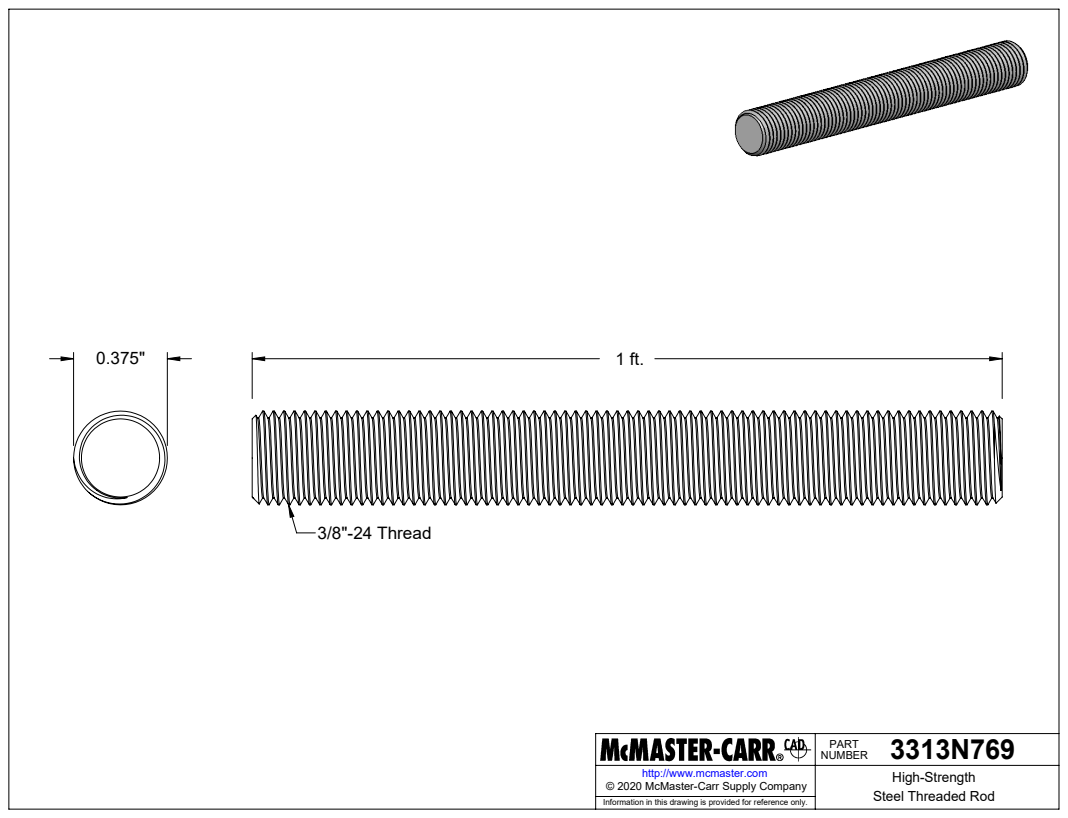
[picture p31: page 1]
3/8"-24 Thread

3313N769 PART NUMBER

http://www.mcmaster.com | High-Strength Steel Threaded Rod © 2020 McMaster-Carr Supply Company

Information in this drawing is provided for reference only.
