giacomofratus/Stretcher_Stabilization/Technical_Drawings/6960T610_SUPER-SWIVEL BALL JOINT ROD END.PDF

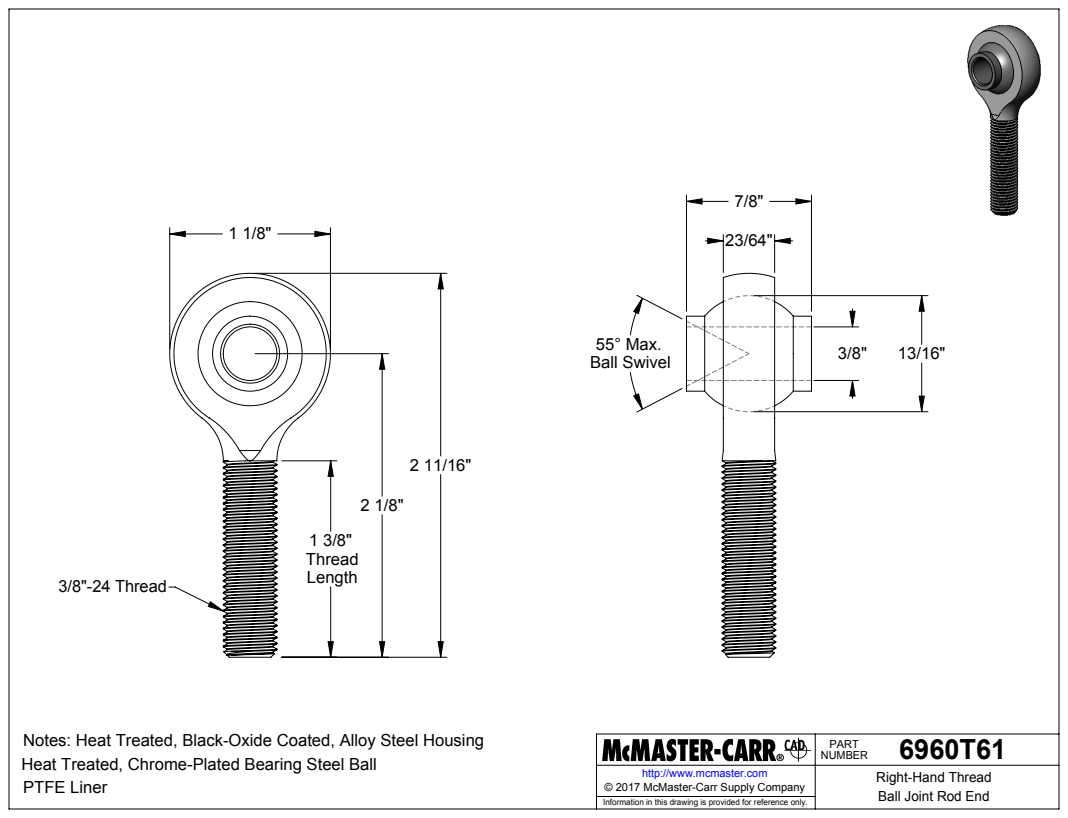
[picture p32: page 1]
3/8"-24 Thread; 13/16" 55° Max.; Ball Swivel

Notes: Heat Treated, Black-Oxide Coated, Alloy Steel Housing
Heat Treated, Chrome-Plated Bearing Steel Ball
PTFE Liner

6960T61 PART NUMBER

http://www.mcmaster.com | Right-Hand Thread Ball Joint Rod End © 2017 McMaster-Carr Supply Company

Information in this drawing is provided for reference only.
