giacomofratus/Stretcher_Stabilization/Technical_Drawings/8412K460_HEAVY DUTY INLINE BOOTED BALL JOINT LINKAGE.PDF

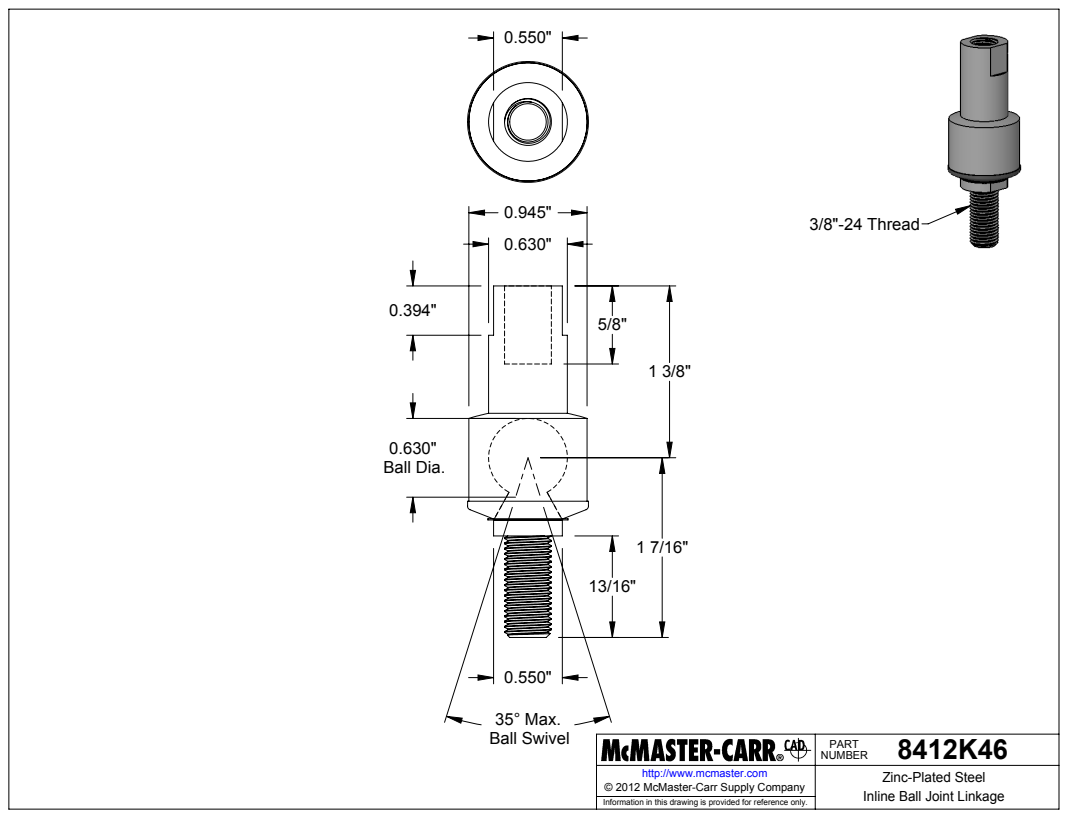
[picture p33: page 1]
35° Max. Ball Swivel; Ball Dia.; 3/8"-24 Thread

8412K46 PART NUMBER

http://www.mcmaster.com | Zinc-Plated Steel Inline Ball Joint Linkage © 2012 McMaster-Carr Supply Company

Information in this drawing is provided for reference only.
