giacomofratus/Stretcher_Stabilization/Technical_Drawings/91309A542_LOW-STRENGTH ZINC-PLATED STEEL CAP SCREW.PDF

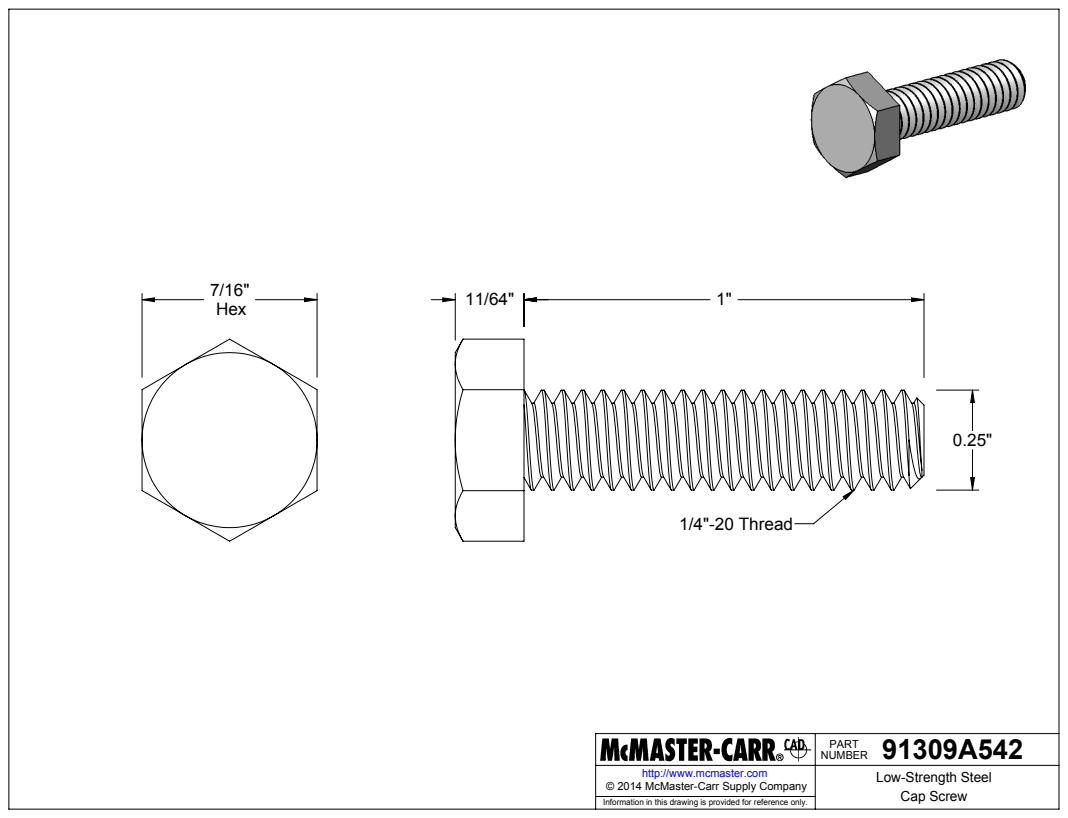
[picture p34: page 1]
1/4"-20 Thread

91309A542 PART NUMBER

http://www.mcmaster.com | Low-Strength Steel Cap Screw © 2014 McMaster-Carr Supply Company

Information in this drawing is provided for reference only.
