giacomofratus/Stretcher_Stabilization/Technical_Drawings/91831A011_TYPE 18-8 STAINLESS STL NYLON-INSERT LOCKNUT.PDF

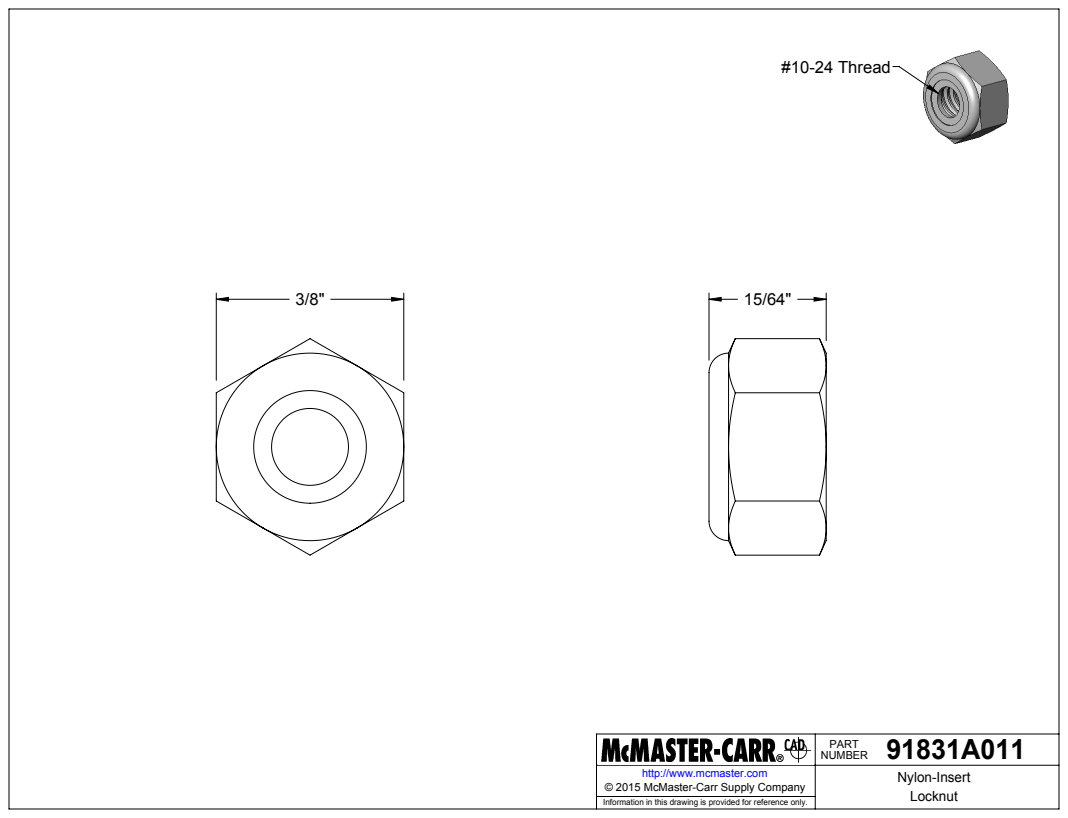
[picture p35: page 1]
#10-24 Thread

91831A011 PART NUMBER

http://www.mcmaster.com | Nylon-Insert Locknut © 2015 McMaster-Carr Supply Company

Information in this drawing is provided for reference only.
