giacomofratus/Stretcher_Stabilization/Technical_Drawings/92141A029_TYPE 18-8 STAINLESS STEEL FLAT WASHER.PDF

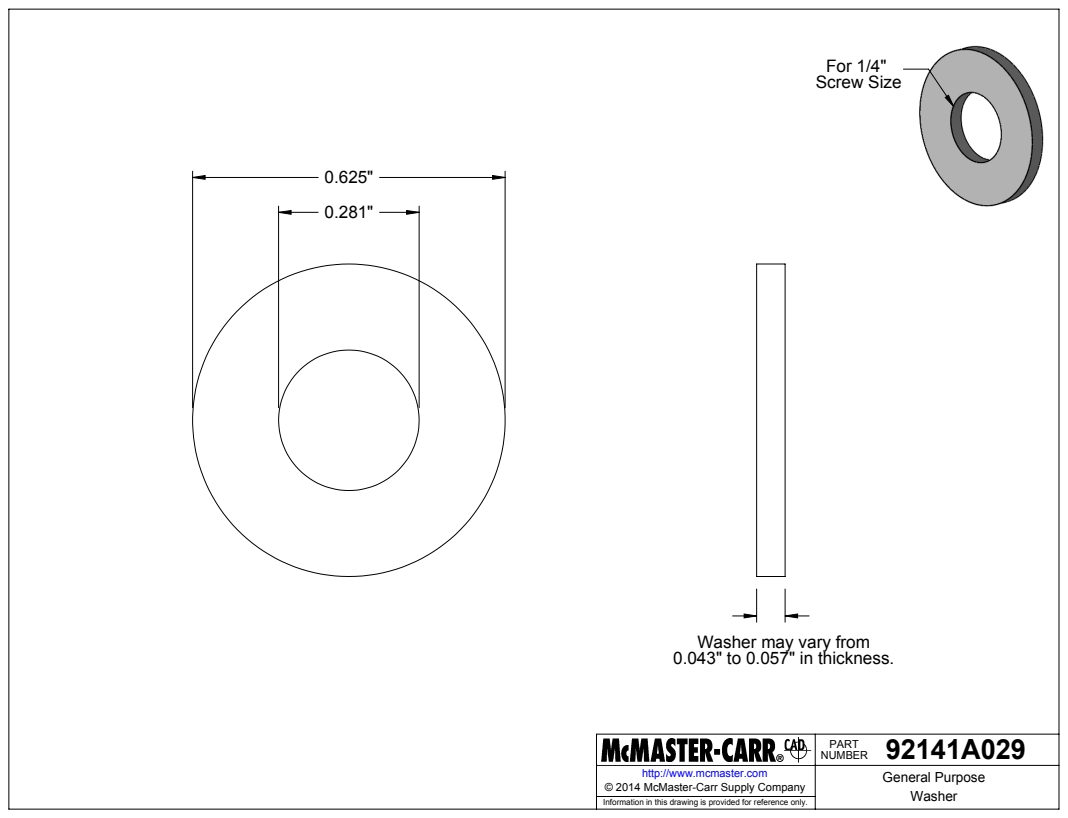
[picture p36: page 1]
For 1/4" Screw Size

Washer may vary from
0.043" to 0.057" in thickness.

92141A029 PART NUMBER

http://www.mcmaster.com | General Purpose Washer © 2014 McMaster-Carr Supply Company

Information in this drawing is provided for reference only.
