giacomofratus/Stretcher_Stabilization/Technical_Drawings/92196A242_18-8 STAINLESS STEEL SOCKET HEAD SCREW.PDF

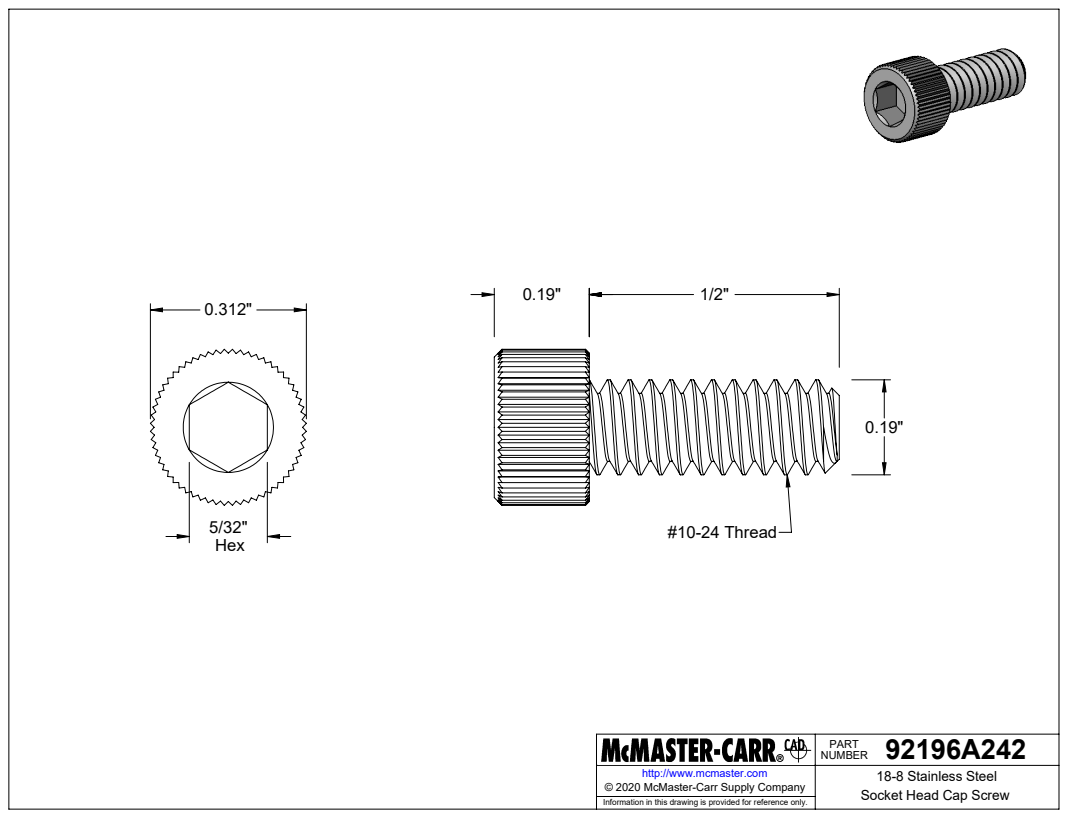
[picture p37: page 1]
#10-24 Thread

92196A242 PART NUMBER

http://www.mcmaster.com | 18-8 Stainless Steel Socket Head Cap Screw © 2020 McMaster-Carr Supply Company

Information in this drawing is provided for reference only.
