giacomofratus/Stretcher_Stabilization/Technical_Drawings/95462A029_GRADE 5 STEEL HEX NUT.PDF

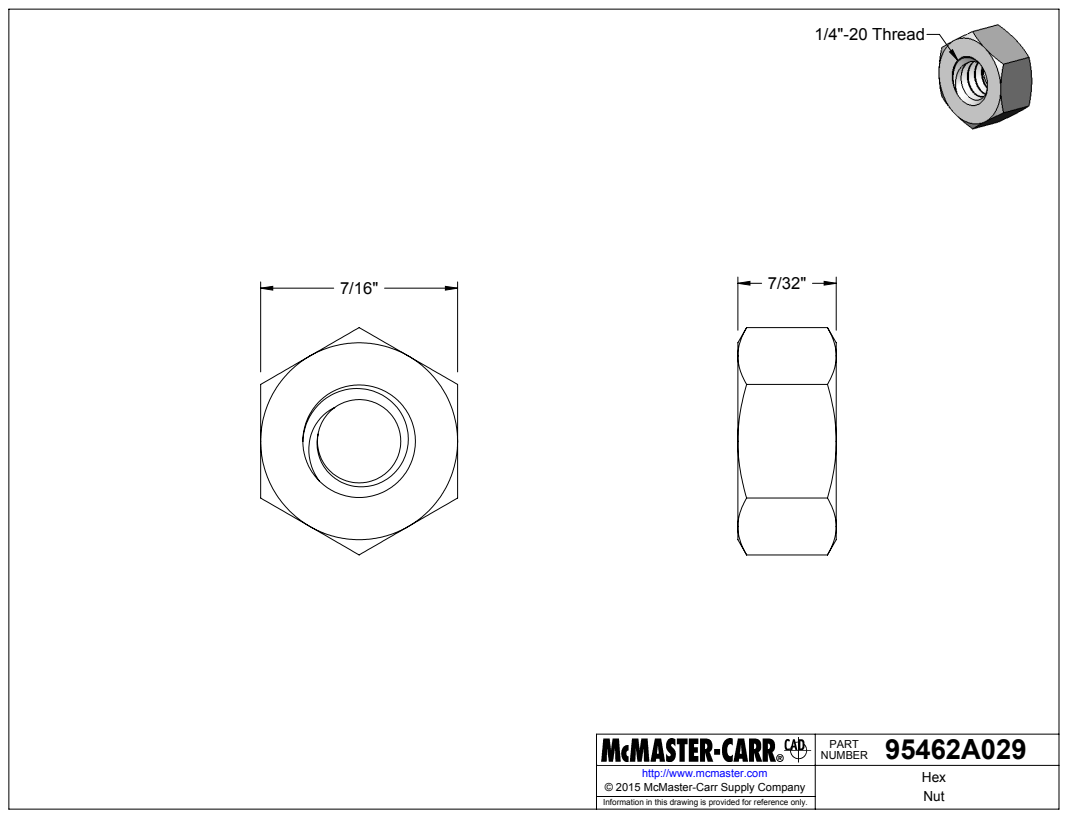
[picture p38: page 1]
1/4"-20 Thread

95462A029 PART NUMBER

http://www.mcmaster.com | Hex Nut © 2015 McMaster-Carr Supply Company

Information in this drawing is provided for reference only.
