giacomofratus/Stretcher_Stabilization/Technical_Drawings/Battery.pdf

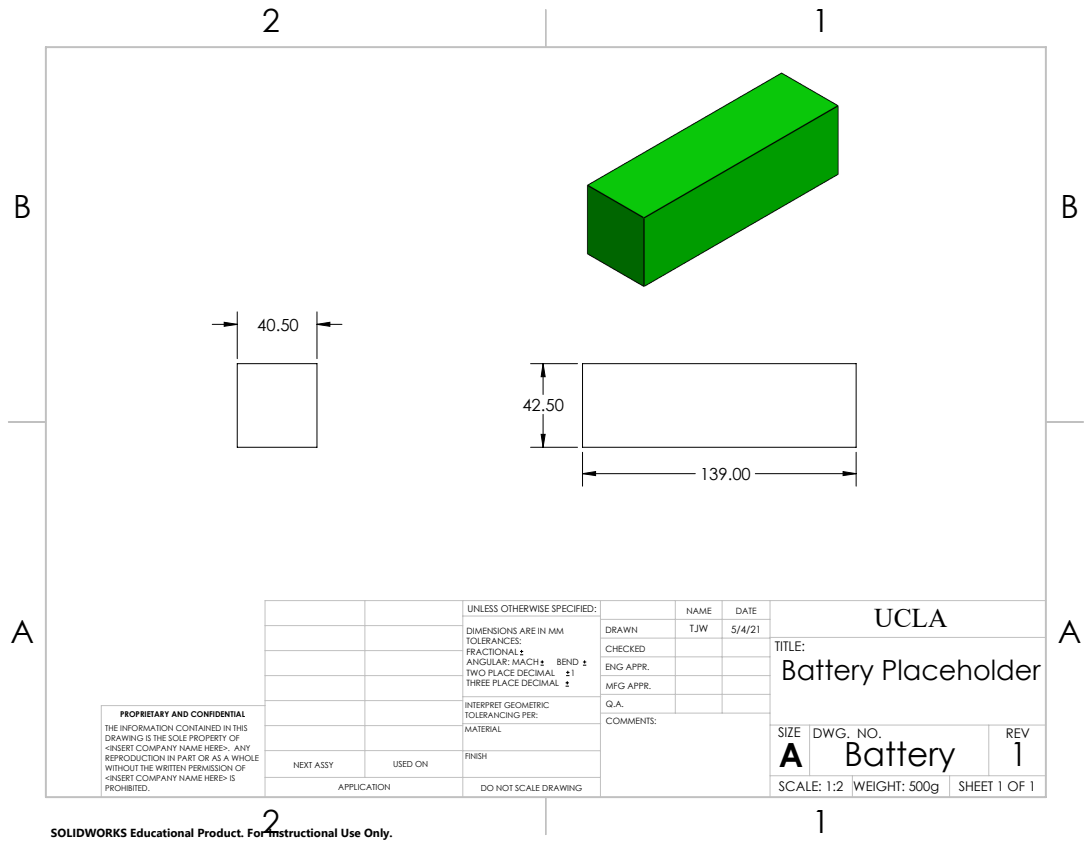
[picture p39: page 1]

UNLESS OTHERWISE SPECIFIED: | | | DATE | UCLA NAME
DIMENSIONS ARE IN MM TOLERANCES: FRACTIONAL ANGULAR: MACH BEND TWO PLACE DECIMAL 1 THREE PLACE DECIMAL | DRAWN | TJW | 5/4/21

CHECKED | | | TITLE: Battery Placeholder

ENG APPR.
MFG APPR.

INTERPRET GEOMETRIC TOLERANCING PER: | Q.A.
MATERIAL | | SIZE A | DWG. NO. Battery | REV 1

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

NEXT ASSY | USED ON | FINISH

APPLICATION | DO NOT SCALE DRAWING | | SCALE: 1:2 | WEIGHT: 500g | SHEET 1 OF 1

SOLIDWORKS Educational Product. For Instructional Use Only.
