giacomofratus/Stretcher_Stabilization/Technical_Drawings/CPU Housing.pdf

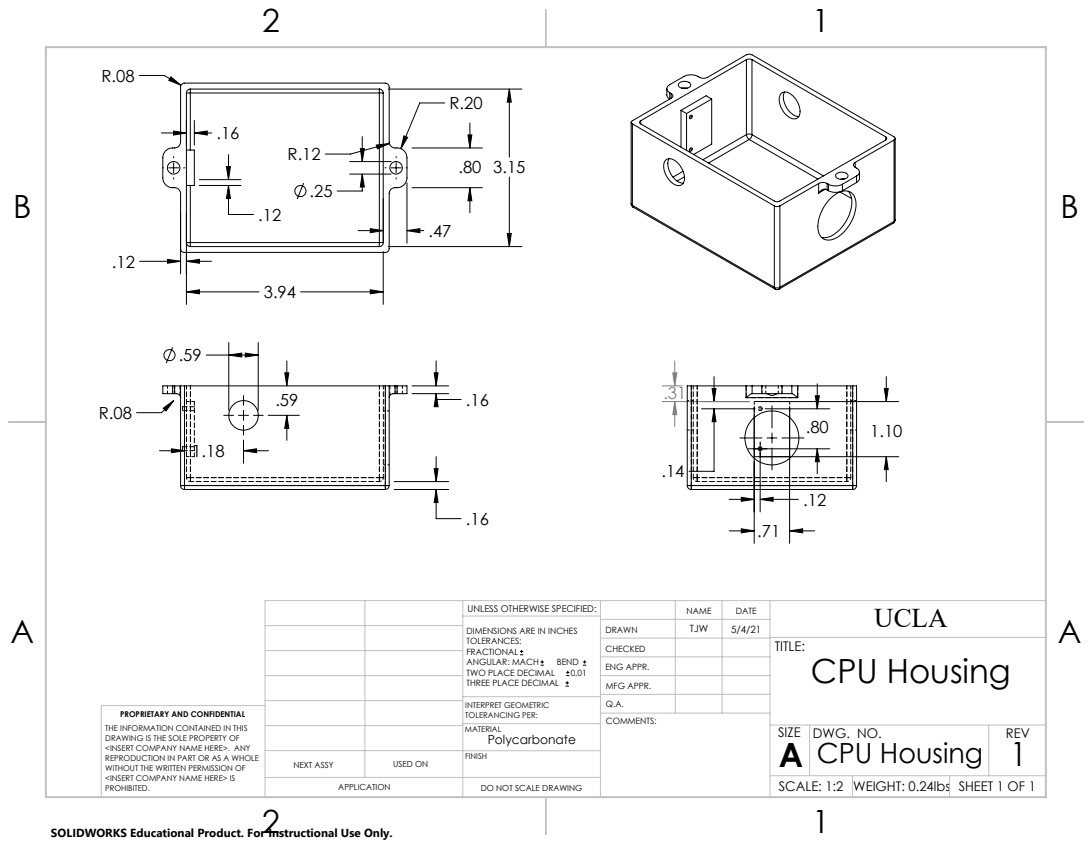
[picture p40: page 1]

UNLESS OTHERWISE SPECIFIED: | | | DATE | UCLA NAME
DIMENSIONS ARE IN INCHES TOLERANCES: FRACTIONAL ANGULAR: MACH BEND TWO PLACE DECIMAL 0.01 THREE PLACE DECIMAL | DRAWN | TJW | 5/4/21

CHECKED | | | TITLE: CPU Housing

ENG APPR.
MFG APPR.

INTERPRET GEOMETRIC TOLERANCING PER: | Q.A.
MATERIAL Polycarbonate | | SIZE A | DWG. NO. CPU Housing | REV 1

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

NEXT ASSY | USED ON | FINISH

APPLICATION | DO NOT SCALE DRAWING | | SCALE: 1:2 | WEIGHT: 0.24lbs | SHEET 1 OF 1

SOLIDWORKS Educational Product. For Instructional Use Only.
