giacomofratus/Stretcher_Stabilization/Technical_Drawings/ElectricHousingFULL.pdf

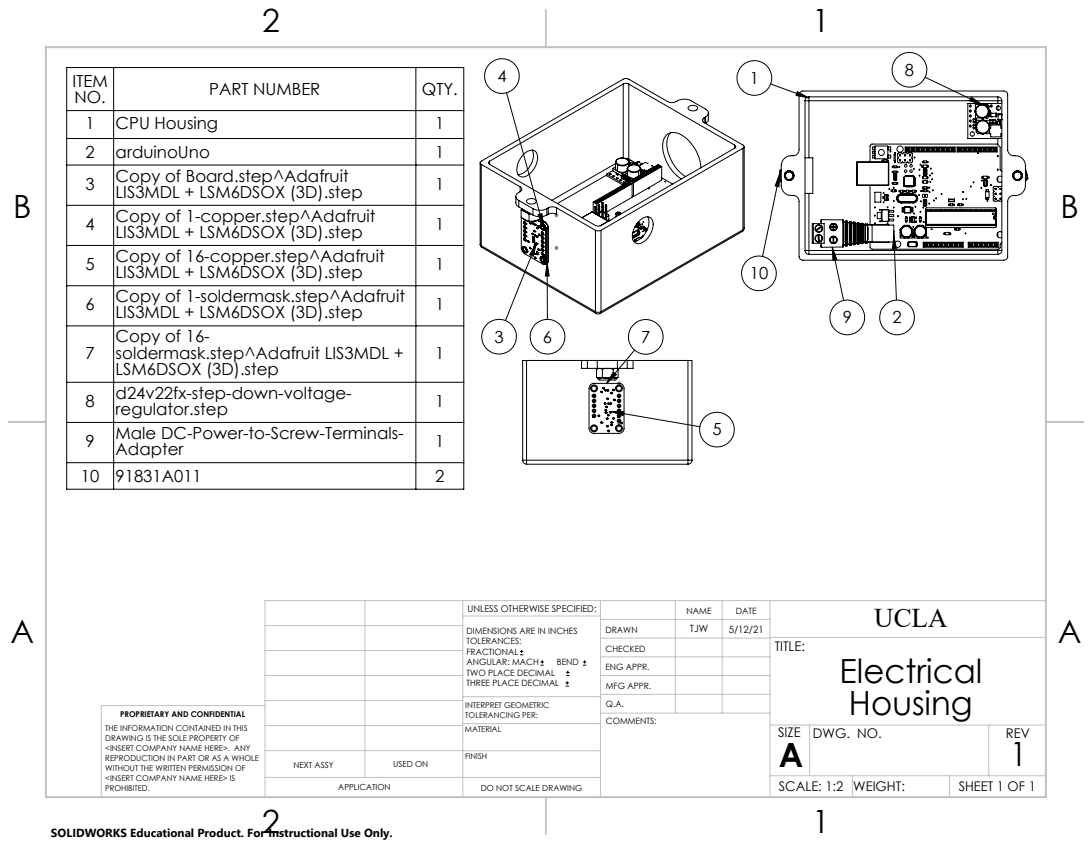
[picture p41: page 1]

NO. | PART NUMBER | QTY. | 4 ITEM

1 | CPU Housing | 1
2 | arduinoUno | 1
3 | Copy of Board.step^Adafruit LIS3MDL + LSM6DSOX (3D).step | 1
4 | Copy of 1-copper.step^Adafruit LIS3MDL + LSM6DSOX (3D).step | 1
5 | Copy of 16-copper.step^Adafruit LIS3MDL + LSM6DSOX (3D).step | 1
6 | Copy of 1-soldermask.step^Adafruit LIS3MDL + LSM6DSOX (3D).step | 1
7 | Copy of 16-soldermask.step^Adafruit LIS3MDL + LSM6DSOX (3D).step | 1

8 | d24v22fx-step-down-voltage-regulator.step | 1
9 | Male DC-Power-to-Screw-Terminals-Adapter | 1
10 | 91831A011 | 2

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

CHECKED | | | TITLE: Electrical Housing

ENG APPR.
MFG APPR.

INTERPRET GEOMETRIC TOLERANCING PER: | Q.A.
MATERIAL | | SIZE A | DWG. NO. | REV 1

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

NEXT ASSY | USED ON | FINISH

APPLICATION | DO NOT SCALE DRAWING | | SCALE: 1:2 | WEIGHT: | SHEET 1 OF 1

SOLIDWORKS Educational Product. For Instructional Use Only.
