giacomofratus/Stretcher_Stabilization/Technical_Drawings/male dc-power-to-screw-terminals-adapter.pdf

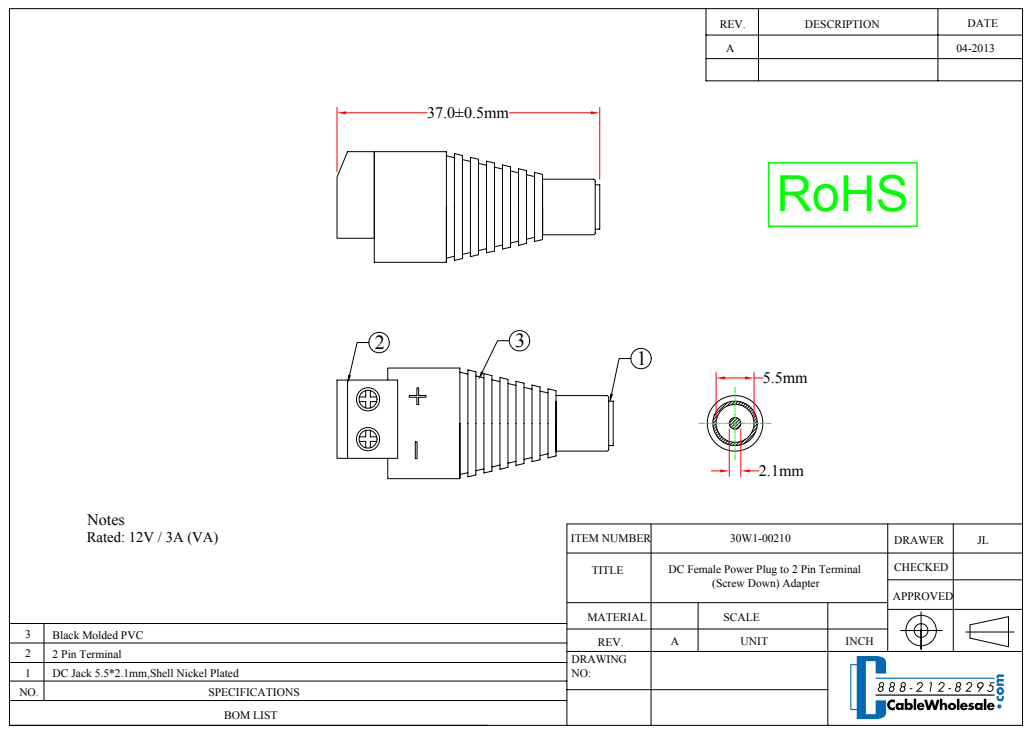
[picture p43: page 1]
ITEM NUMBER; BOM LIST; Rated: 12V / 3A (VA)

DC Female Power Plug to 2 Pin Terminal
(Screw Down) Adapter

Black Molded PVC
2 Pin Terminal
DC Jack 5.5*2.1mm,Shell Nickel Plated
