giacomofratus/Stretcher_Stabilization/Technical_Drawings/Pipe Fitting Corner Mount.pdf

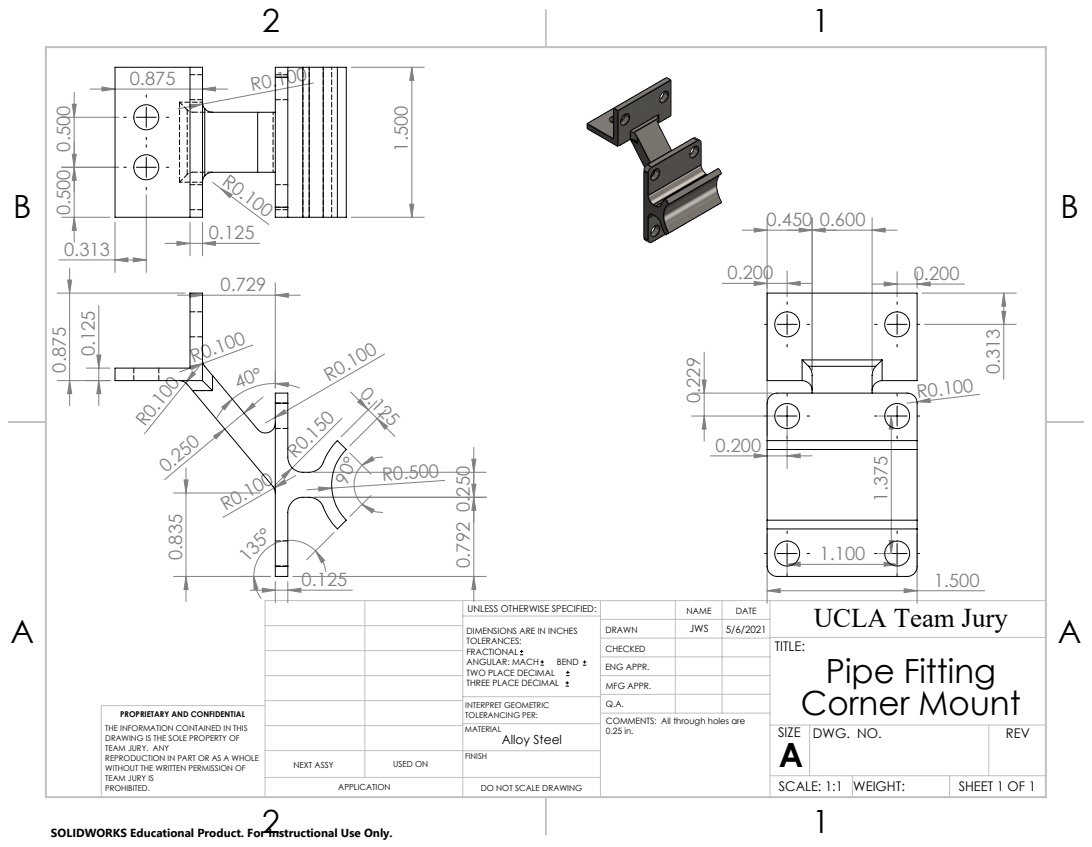
[picture p44: page 1]

UNLESS OTHERWISE SPECIFIED: | | | DATE | UCLA Team Jury NAME
DIMENSIONS ARE IN INCHES TOLERANCES: FRACTIONAL ANGULAR: MACH BEND TWO PLACE DECIMAL THREE PLACE DECIMAL | DRAWN | JWS | 5/6/2021

CHECKED | | | TITLE: Pipe Fitting Corner Mount

ENG APPR.
MFG APPR.

INTERPRET GEOMETRIC TOLERANCING PER: | Q.A.
MATERIAL Alloy Steel | | SIZE A | DWG. NO. | REV

PROPRIETARY AND CONFIDENTIAL
THE INFORMATION CONTAINED IN THIS
DRAWING IS THE SOLE PROPERTY OF
TEAM JURY. ANY
REPRODUCTION IN PART OR AS A WHOLE
WITHOUT THE WRITTEN PERMISSION OF
TEAM JURY IS
PROHIBITED.

COMMENTS: All through holes are

NEXT ASSY | USED ON | FINISH

APPLICATION | DO NOT SCALE DRAWING | | SCALE: 1:1 | WEIGHT: | SHEET 1 OF 1

SOLIDWORKS Educational Product. For Instructional Use Only.
